CalPlug/ADE9078-3PhaseWattmeter/PCBDesign/1.4Fv3(PCB Populated)/Board PDF images/layout_images/IMG_20190212_175402.jpg

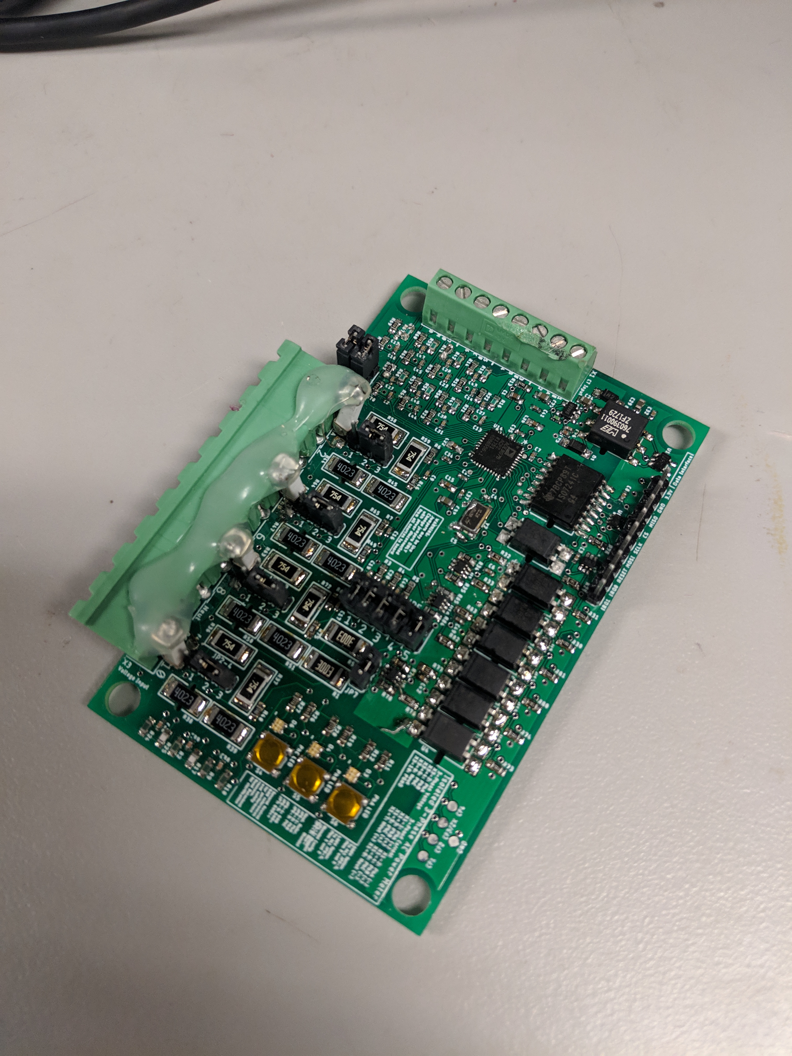
PCBDesign/1.4Fv3(PCB Populated)/Board PDF images/layout_images/IMG_20190212_175402.jpg
