CalPlug/ADE9078-3PhaseWattmeter/README.md

# ADE9078-3PhaseWattmeter
An Isolated design demo board using the ADE7953 3 phase AC wattmeter.  Design allows both WYE (STAR) and Delta (TRIANGLE) distributions to be measured along with Blondel and non-Blondel measurement schemes.  Project includes a demo ADE9078 Arduino firmware
