CalPlug/ADE9078-3PhaseWattmeter/PCBDesign/1.4Fv4/Readme.txt

This version contains minor updates post population.  These updates have been propataged the BOM and PCN layout
--M.J. Klopfer (/4/12/2019)
