CalPlug/ADE9078-3PhaseWattmeter/Firmware/FPGAPreliminaryFirmware/readme.txt

This is a skeleton layout of a Lattice iCE 40 interface over SPI to the ADE9078.  It is not complete at the current time, all basic features have not been implemented.
