CalPlug/ADE9078-3PhaseWattmeter/Firmware/ArduinoFirmware/ADE9078/examples/resampledWFB_readall/README.txt

reads all 512 samples at once instead of 64x8

in LastReads.h, change WFB_RESAMPLE_SEGMENTS to 512
