CalPlug/ADE9078-3PhaseWattmeter/Documents/3 Phase Utility Service and Metering Configurations.pdf

### 3 Phase Utility Service and Metering Configurations

A review by Michael Klopfer, PhD

University of California, Irvine

California Plug Load Research Center (CalPlug)

California Institute of Telecommunications and Information Technology (Calit2)

V1.1

Overview: Distribution of AC power from generation to consumption points often relies on conversion between polyphase (almost always 3-phase) and single phase AC. Three phase power in general allows more power to be delivered to loads with less wire cost as well as providing consistent instantaneous power across a single AC cycle. In this document we will briefly discuss service configurations and accepted metering strategies.

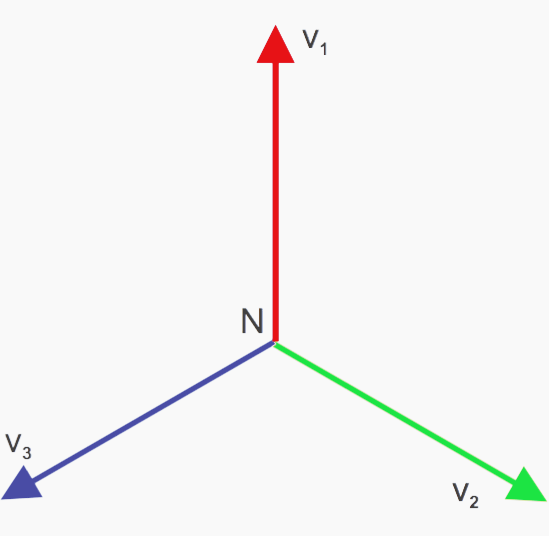
[picture p17: figure]
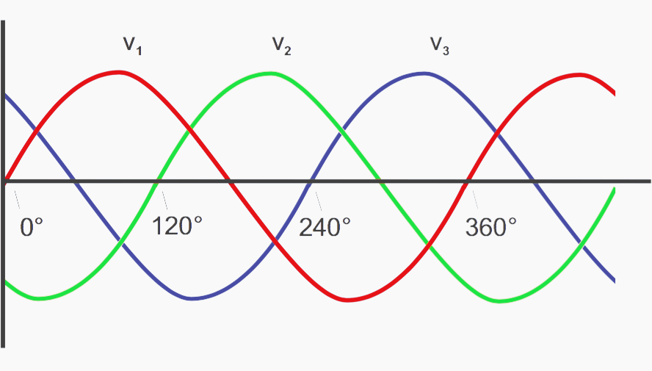
[picture p18: figure]

Figure 1: Three phase voltage represented in both waveform (left) and phase (right) diagrams.

Utility Internal Service: 3-phase transmission (shown in time and phase diagrams in Figure 1) and early distribution service is typically delta configured. Towards the final utility distribution transformer, the 3-phase service is typically provided in either Wye [a.k.a STAR] (3 or 4 lines, typically 4 lines including each phase and an active neutral that may be used for power return), or Delta [a.k.a TRIANGLE] (3 phases and often if a neutral is included, it is not used for primary power return), see Figure 2. For long stretches of transmission delta is preferred due to the lack of need for a power return neutral of sufficient carrying capacity.

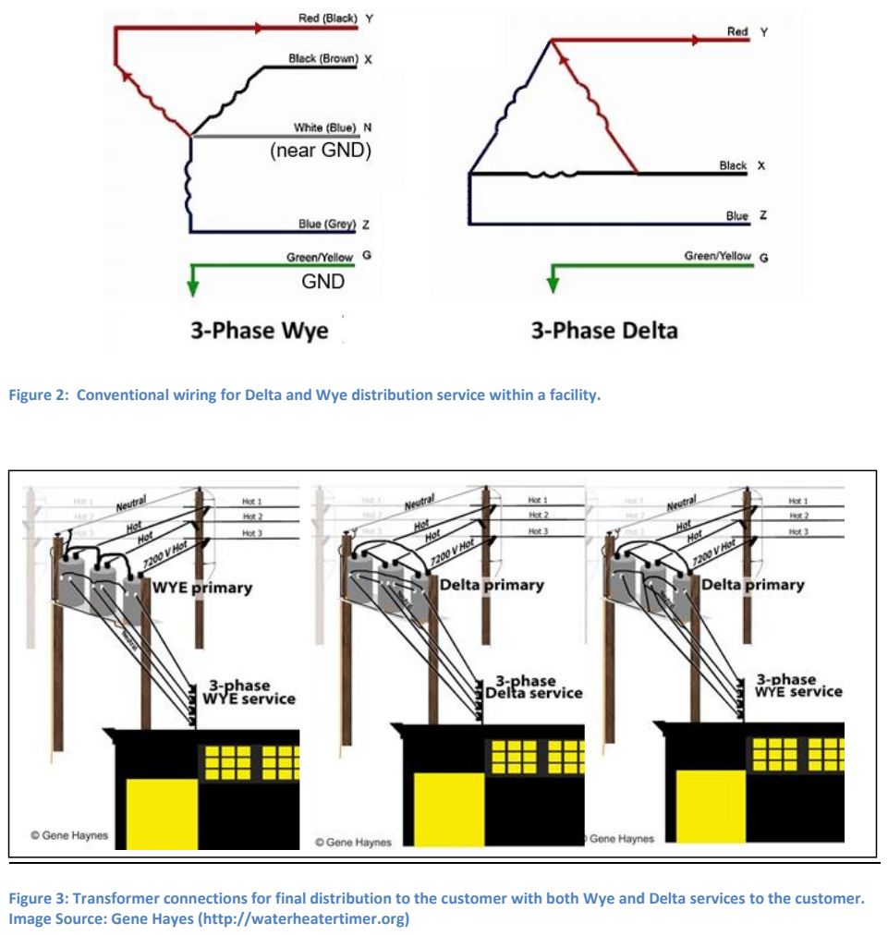
[picture p19: page 2]

Figure 2: Conventional wiring for Delta and Wye distribution service within a facility.

Figure 3: Transformer connections for final distribution to the customer with both Wye and Delta services to the customer. Image Source: Gene Hayes (http://waterheatertimer.org)

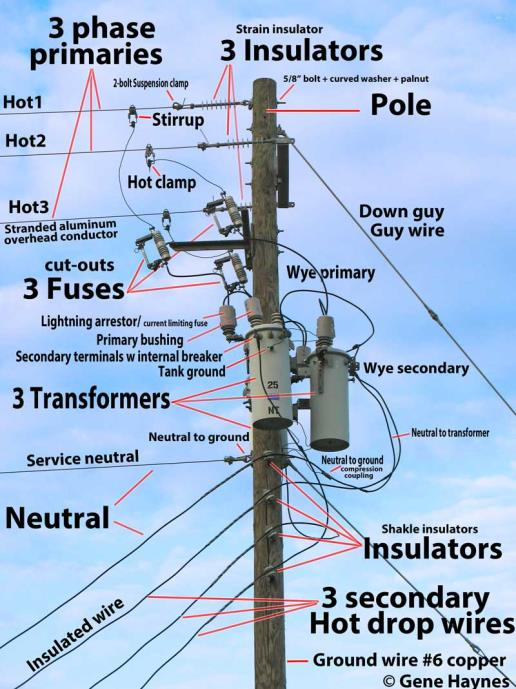
[picture p20: figure]
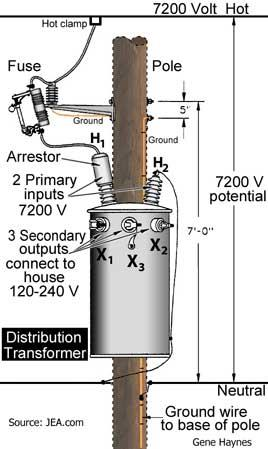
[picture p21: figure]

Figure 4(a,b): In end-pint distribution networks, a Wye- Wye configurations are common either multiple (a) primaries or a singular primary to neutral (b) can be provided to the transformer prior to the customer. Image Source: Gene Hayes (http://waterheatertimer.org)

Typically large-scale utility connections are delta configured. A neutral may be carried along that is grounded at multiple points but it is not used for active intended power carrying in delta configuration. Closer to distribution endpoints utility configuration typically remains as delta up to the final distribution transformer, but in some cases it may enter Wye configuration prior to distribution. In general, closed Delta configurations use less wire (typically expensive copper) in use and balance voltage that the expense of current. Delta systems are used for transmission even with current being potentially higher. A High leg delta is a configuration to provide a neutral and split phase in addition to 3 phase service with a limited load capacity. For Delta systems in general, the source of ground faults are difficult to detect due to lack of neutral comparison reference against each phase.

Utility to customer service: At the transition point where power is provided to the customer, the service is often provided as Delta (for major loads such as large motors or lighting services), Wye (general purpose loads, lighting, and loads requiring neutrals), or Split Phase (provided to residences). Service to most commercial buildings is 208V (phase to phase) 3-phase (Wye) or 480V (phase to phase) 3-phase (Wye), this configuration provides a neutral.

Table 1 shows common US and international service configurations. Figure 2 shows the typical layout for both conventional Delta and Wye configurations. Some atypical services include low service capacity high-leg deltas which provide a 120/240 split-phase in addition to a 3-phase delta service which may find service in applications such as small apartment buildings using 3-phase elevators or HVAC units along with conventional 120/240V service.

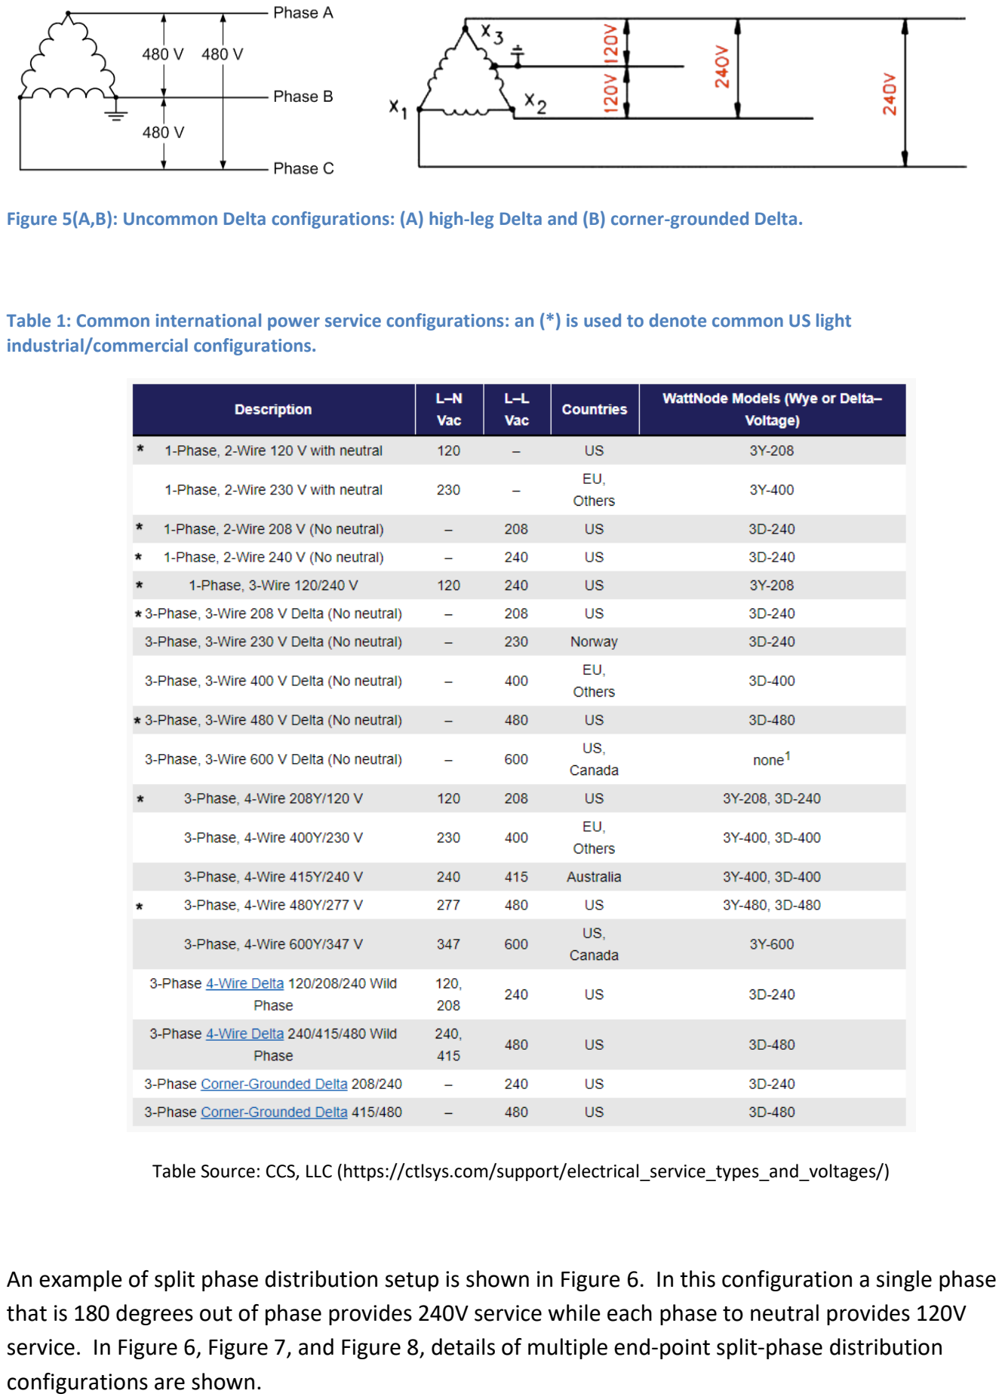
[picture p22: page 4]

Figure 5(A,B): Uncommon Delta configurations: (A) high-leg Delta and (B) corner-grounded Delta.

Table 1: Common international power service configurations: an (*) is used to denote common US light industrial/commercial configurations.

Table Source: CCS, LLC (https://ctlsys.com/support/electrical_service_types_and_voltages/)

An example of split phase distribution setup is shown in Figure 6. In this configuration a single phase that is 180 degrees out of phase provides 240V service while each phase to neutral provides 120V service. In Figure 6, Figure 7, and Figure 8, details of multiple end-point split-phase distribution configurations are shown.

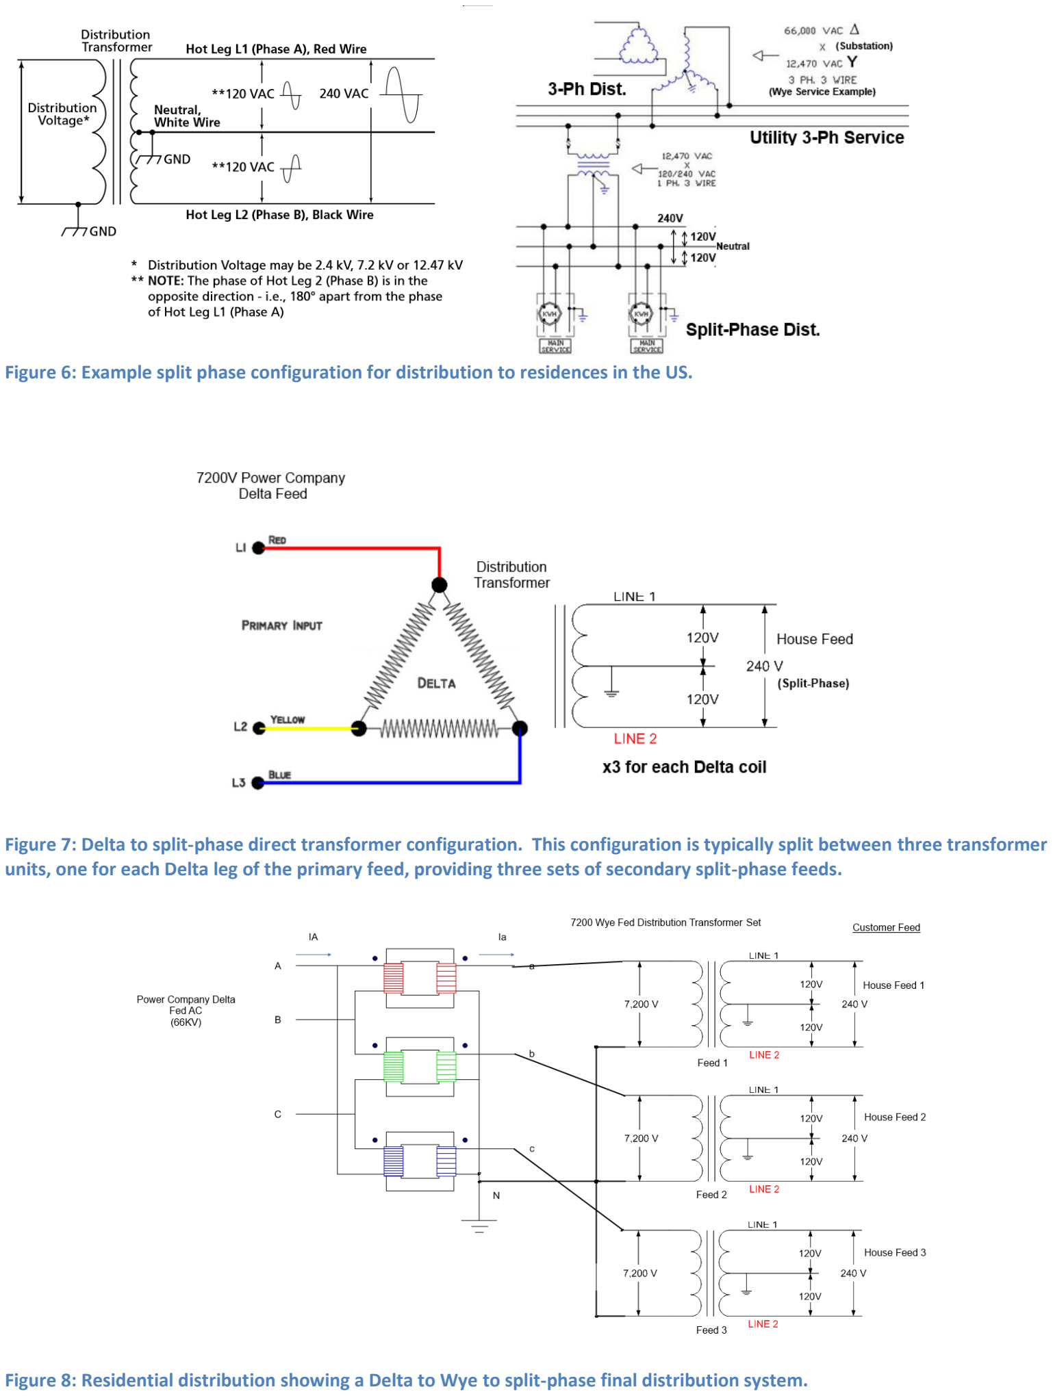
[picture p23: page 5]

Figure 6: Example split phase configuration for distribution to residences in the US.

Figure 7: Delta to split-phase direct transformer configuration. This configuration is typically split between three transformer units, one for each Delta leg of the primary feed, providing three sets of secondary split-phase feeds.

Figure 8: Residential distribution showing a Delta to Wye to split-phase final distribution system.

Measurement of Power in Split Phase and 3 Phase Service:

Blondel’s theorem indicates in multiple measurement cases (n-1) total phases are the required meters needed to know total energy consumption for a polyphase circuit in configurations that adhere to Blondel theorem. Under-defined configurations (non-Blondel compliant) can occur when neutrals are in use and in which case explicit metering on each pathway is required. Below are shown are several split-phase and 3 phase configurations that are commonly used along with metering strategies and identification of Blondel’s theorem compliance for each configuration.

Case 0: Split phase AC distribution using a “Form2S” type meter. Form 3S meters use external current transformers for measuring large loads. The sum of the power calculated on each of the split phases is total power consumption. This is a common configuration for utility meters for split-phase supplied homes. The neutral return for either of the split-phases makes this distribution configuration non-Blondel theorem compliant- each phase must be independently metered to measure total energy consumption.

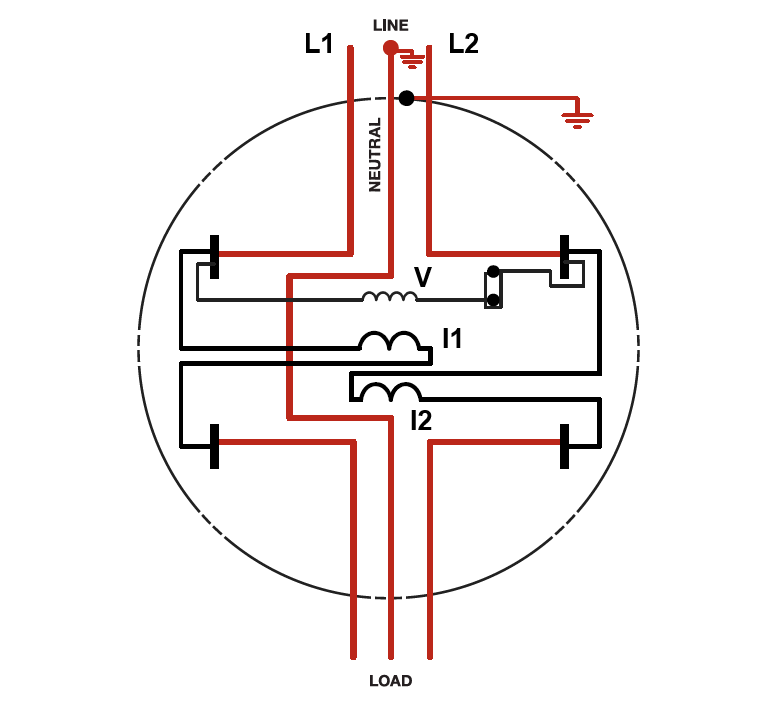
[picture p24: figure]

Case 1 and Case 2: Either (1) Wye (no neutral) or (2) delta 3-phase service (non-Blondel compliant) using 3 meters to measure 3 phases.

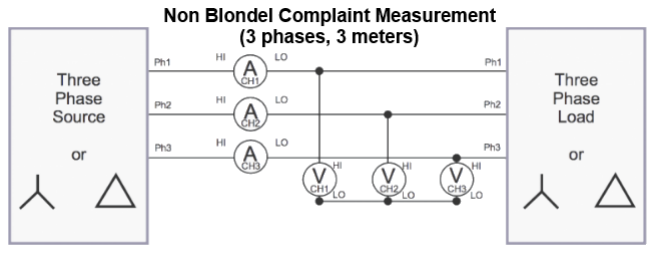
[picture p25: figure]

Case 3: Wye configuration with a neutral. This configuration is not Blondel compliant (or could ever be) because of the neutral. Each phase must be monitored and the power on the neutral is (typically) calculated by process of Kirchoff's laws. This configuration is typical for many commercial buildings because 208V phase-phase provides 120V phase to neutral for service outlets. Figure Source: https://electrical-engineering-portal.com/three-phase-power-measurement#three-wattmeter-method

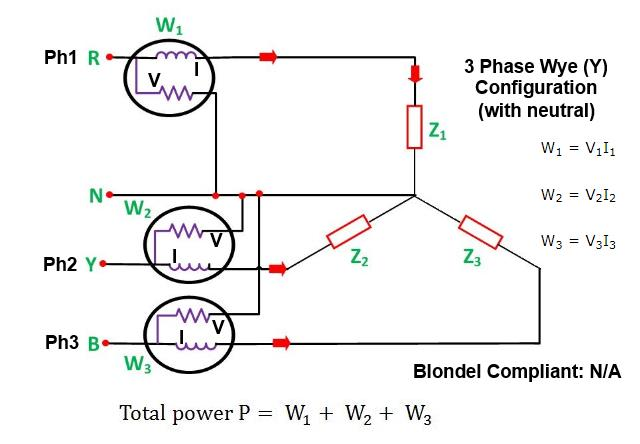
[picture p26: figure]

Case 4: Delta service: This Blondel compliant approach uses two meters to measure power across 3 phases.

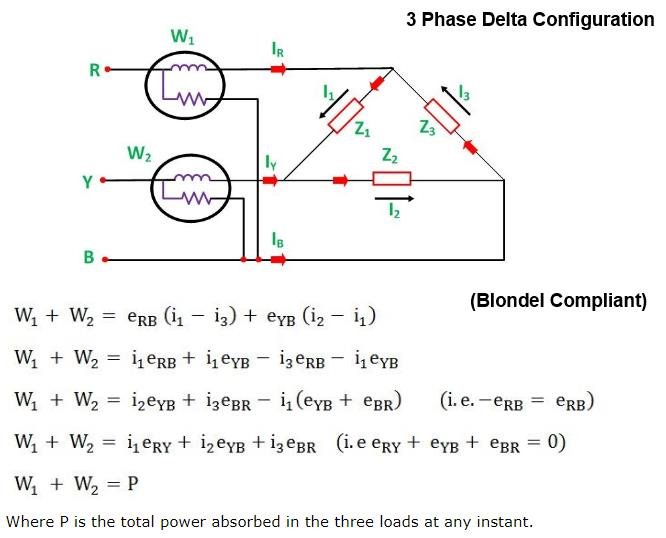
[picture p27: figure]

Case 5: Wye service without a neutral: This Blondel compliant approach uses two meters to measure power across 3 phases in a WYE service with no neutral in use.

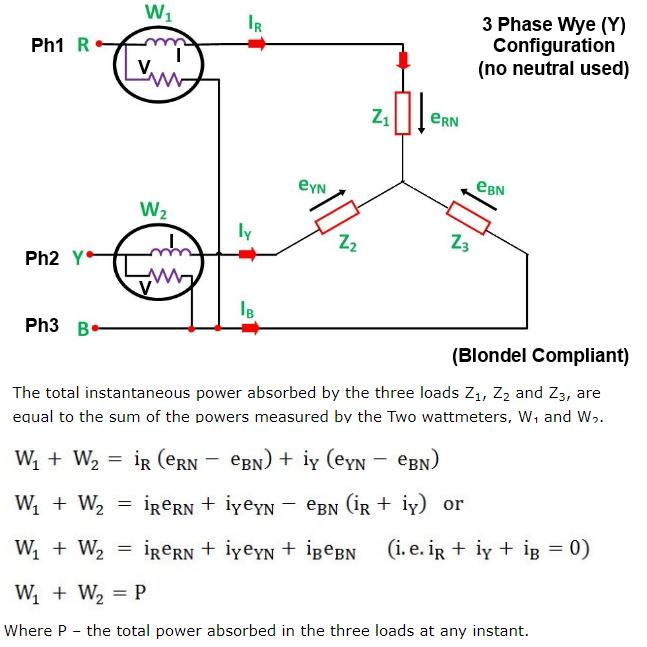
[picture p28: figure]
