CalPlug/ADE9078-3PhaseWattmeter/PCBDesign/simulations/LTSpice/Sim1-CTSimulationCurrentInput/image (50).png

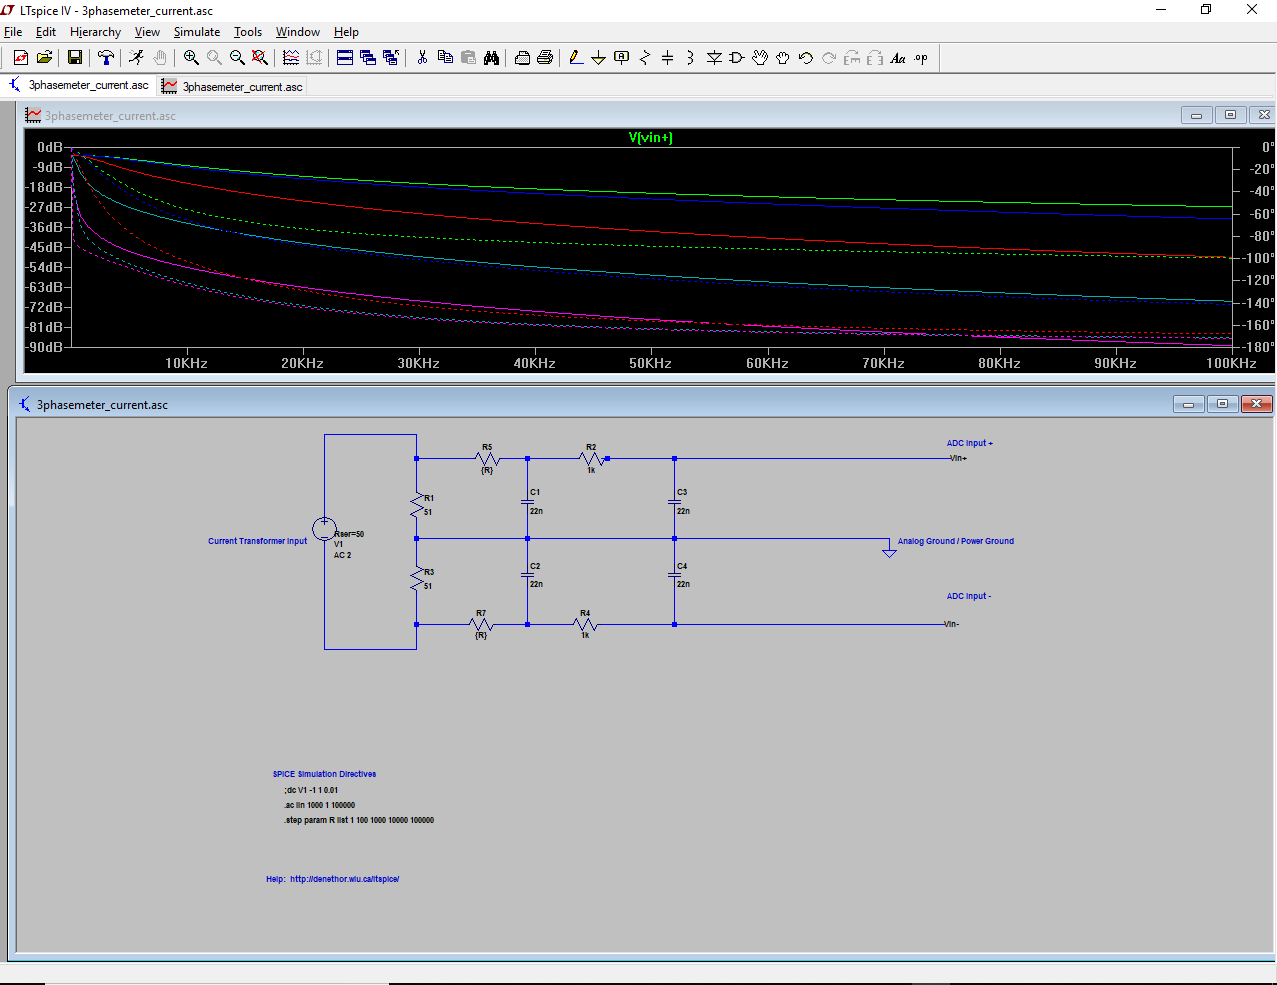
PCBDesign/simulations/LTSpice/Sim1-CTSimulationCurrentInput/image (50).png
