CalPlug/ADE9078-3PhaseWattmeter/PCBDesign/simulations/LTSpice/Sim1-CTSimulationCurrentInput/image (51).png

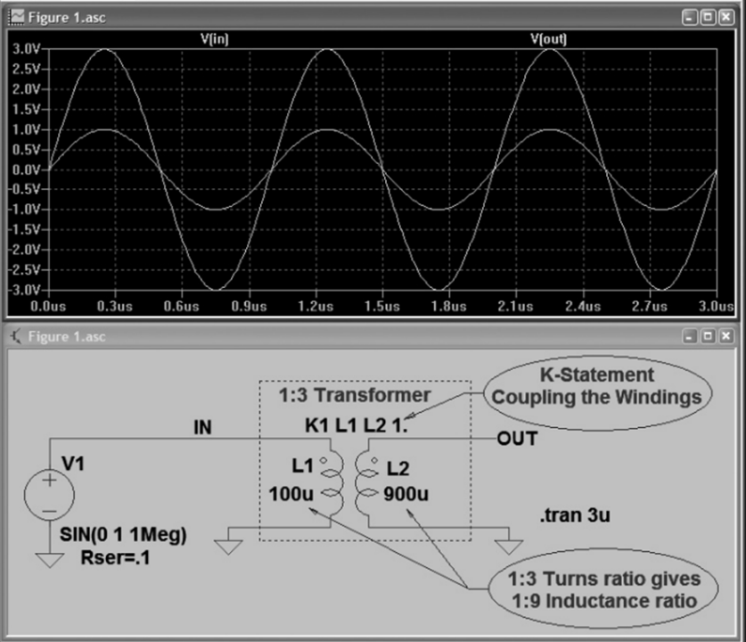
PCBDesign/simulations/LTSpice/Sim1-CTSimulationCurrentInput/image (51).png
