CalPlug/ADE9078-3PhaseWattmeter/PCBDesign/simulations/LTSpice/Sim1-CTSimulationCurrentInput/image (52).png

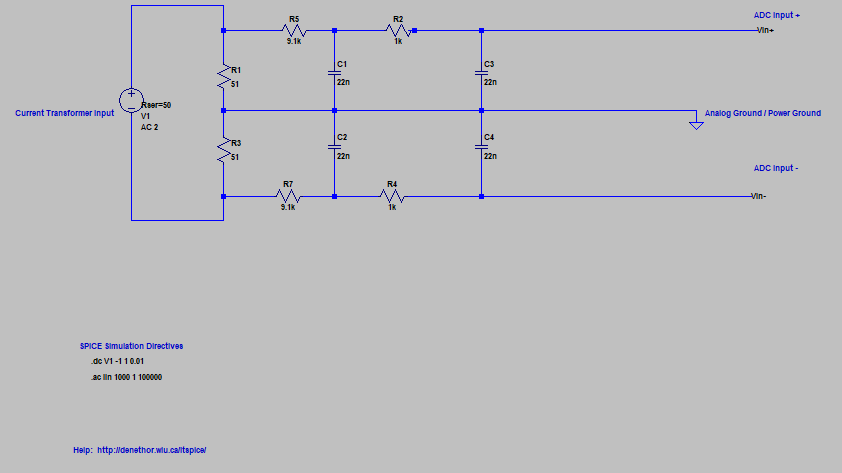
PCBDesign/simulations/LTSpice/Sim1-CTSimulationCurrentInput/image (52).png
