CalPlug/ADE9078-3PhaseWattmeter/PCBDesign/1.4Fv4/BOM - Three Phase Wattmeter.xlsx

Sheet: PCB SPECS (please fill in)
PCB
File Name | Material | Layer | Dimension(mm) |  | Quantity (5 min.) | Separated Different Design | Panelized PCBs | Solder Mask Color | Silkscreen Color | PCB Thickness | Copper Thickness | Inner Copper Thickness | Surface Finish
 |  |  | X | Y |  |  |  |  |  | (mm) | (oz) | (oz)
***.ZIP (your Gerber files) | FR-4 TG130 | 2 | 87.63 | 57.15 | 5 | 1 | Not Required | Green | White | 1.6 | 1 oz | 0.5 oz | HASL (Hot Air Surface Leveling)
SPECIAL REQUIREMENTS
Min. Tracking/Spacing | 6 mil
Min. Hole Size | 0.3 mm
BGA | No
Edge Connector | No
Blind Vias | No
Half Cutted Holes | No
Impedance Control | No
STENCIL
Stencil Dimensions | 190 x 290 mm (frameless)
Stencil Quantity | 1
Fiducial Mark | Yes
Polishing Technique | Polishing
REMARK
Milling slots on Layer 46, Holes on Layer 45

Sheet: BOM (please fill in)
BOM/PCBA quantity (Required) |  | 5.00
PCB/Project Name (Required) |  | 3 Phase Wattmeter
Part Identification |  |  |  |  |  | Customer Information |  | Quantity | Remark
# | Part ID / Reference (Required) | Value (Required) | Package (Required) | THT (y/n) | Pins / Pads Qty | Source/Link/ Datasheet/Note | Source / Target Price | Quantity per BOM (Required)
1 | C3,C6,C7,C8,C26,C32,C34,C37,C41,C42,C49 | CAP CER .1UF 16V | 0402 | n | 2 | https://www.mouser.com/ProductDetail/KEMET/C0402C104M4PACTU | $0.14 | 11
2 | C25 | CAP CER 1UF 16V | 0402 | n | 2 | https://www.mouser.com/ProductDetail/Murata-Electronics/GRM155C81C105ME11D | $0.27 | 1
3 | C2,C9,C10,C11,C12,C13,C14,C16,C17,C19,C20, | CAP CER 22NF 16V | 0402 | n | 2 | https://www.mouser.com/ProductDetail/Yageo/AC0402KRX7R7BB223 | $0.10 | 22
 | C21,C23,C28,C30,C31,C43,C44,C45,C46,C47,C48
4 | C15,C22,C36 | CAP CER 4.7 UF 16V | 0402 | n | 2 | https://www.mouser.com/ProductDetail/Murata-Electronics/GRM155R61A475MEAAD | $0.25 | 3
5 | C18,C35 | CAP CER .22uF 16V | 0402 | n | 2 | https://www.mouser.com/ProductDetail/Taiyo-Yuden/JMK105BJ224KE-R | $0.38 | 2
6 | C4,C5 | CAP CER 30pF 16V | 0402 | n | 2 | https://www.mouser.com/ProductDetail/Taiyo-Yuden/TMK042CG300JC-W | $0.10 | 2
7 | C38,C39,C40 | CAP CER 50nF 16V | 0402 | n | 2 | https://www.mouser.com/ProductDetail/TDK/C1005X8R1E473M050BC | $0.18 | 3
8 | C1 | CAP CER 1UF 16V | 0603 | n | 2 | https://www.mouser.com/ProductDetail/KEMET/C0603X105J4RACTU | $0.500 | 1
9 | C24,C27,C29,C33 | CAP CER 10UF 16V | 0603 | n | 2 | https://www.mouser.com/ProductDetail/KEMET/C0603C106M8PACTU | $0.500 | 4
10 | L1 | INDUCTOR 15nH | 0402 | n | 2 | https://www.mouser.com/ProductDetail/Murata-Electronics/LQG15WH15NJ02D | $0.17 | 1
11 | R16, R18, R42, R43, R54, R55, R66, R67 | 20 ohm res | 0603 | n | 2 | https://www.digikey.com/product-detail/en/te-connectivity-passive-product/CPF0603F4R99C1/A102290CT-ND/2728264 | $0.14 | 8
12 | R14, R22, R41, R56, R57, R60, R68, R69 | 100 ohm res | 0603 | n | 2 | https://www.digikey.com/product-detail/en/susumu/RR0816P-101-D/RR08P100DCT-ND/432700 | $0.11 | 8
13 | R29, R32, R33, R76, R77, R82, R83 | 560 ohm res,100V,100mW | 0603 | n | 2 | https://www.mouser.com/ProductDetail/Susumu/RGT1608P-561-B-T5 | $0.73 | 7
14 | R3, R4,R5,R6,R7,R8,R15,R21,R23, R53, R61, R62, R70, R71 | 1k Ohm res, 75V, 100mW | 0603 | n | 2 | https://www.mouser.com/ProductDetail/Yageo/AT0603BRD071KL | $0.60 | 14
15 | R13,R28,R30,R31, R73, R74, R80, R81 | 4.7k ohm res, 75V,100mW | 0603 | n | 2 | https://www.mouser.com/ProductDetail/Vishay/CRCW06034K70FKEAC | $0.17 | 8
16 | R2, R9, R10, R11, R12, R17, R19, R20, R24, R25, R26,R27 | 5k ohm,75V,62.5mW | 0603 | n | 2 | https://www.mouser.com/ProductDetail/KOA-Speer/RN731JTTD5051B25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 | $0.67 | 12
17 | R34,R35, R78, R79, R84, R85 | 10k ohm res,75V,100mW | 0603 | n | 2 | https://www.mouser.com/ProductDetail/Vishay/CRCW060310K0JNEAC | $0.17 | 6
18 | R1, R52 | 300k ohm,200V,750mW | 2010 | n | 2 | https://www.mouser.com/ProductDetail/Yageo/RC2010FK-07300KL | $0.30 | 2
19 | R38,R39,R44, R45, R47, R48, R50, R51 ** Values changes from last sch | 120k ohm,200V, 750mW | 2010 | n | 2 | https://www.mouser.com/ProductDetail/Yageo/RC2010JK-07120KL | $0.22 | 8
20 | R36,R37, R58, R59, R63, R64, R65, R72 ** | 245k ohm,200V,750mW | 2010 | n | 2 | https://www.mouser.com/ProductDetail/Panasonic/ERJ-12ZYJ244U | $0.30 | 8
21 | R40, R46, R49, R75 ** | 120k ohm,75V,100mW | 0603 | n | 2 | https://www.mouser.com/ProductDetail/Vishay/CRCW0603120KFKEAC | $0.17 | 4
22 | U14 | Energy Metering IC | ADE 9078 | n | 40 | https://www.mouser.com/ProductDetail/Analog-Devices/ADE9078ACPZ | $12.280 | 1
23 | S4, S5, S6 | Switch | TACTILE_SWITCH_SMD_4.5MM | n | 2 | https://www.digikey.com/product-detail/en/TL3315NF100Q/EG4620CT-ND/1870400/?itemSeq=283064735 | $0.230 | 3
24 | X3 | 10 Pins Terminal Block | MSTBA10 | n | 10 | https://www.mouser.com/ProductDetail/Phoenix-Contact/1757323 | $3.240 | 1
25 | X1 | 8 Pins Terminal Block | MKDS 1/ 8-3,5 |  | 8 | https://www.mouser.com/ProductDetail/Phoenix-Contact/1751303?qs=sGAEpiMZZMuVJC7Vq%252bMl5xHSGUvYpdrt | $5.010 | 1
26 | F1, F2, F3, F4 | Fuses | Surface Mount Fuses | n | 2 | https://www.mouser.com/ProductDetail/Littelfuse/0461500ER | $1.720 | 4
27 | D3, D4, D6 | LED | Bi-Color LEDs (Red/Green) | n | 4 | https://www.mouser.com/ProductDetail/Wurth-Electronics/150066SV74000 | $0.400 | 3
28 | D1, D2 | Diode | MBR0520LT | n | 2 | https://www.digikey.com/product-detail/en/micro-commercial-co/MBR0520-TP/MBR0520TPMSCT-ND/717365 | $0.420 | 2
29 | U2,U3,U4,U6,U9,U15,U17 | PS2505 (High isolation voltage connector) | PS2505 | n | 4 | https://www.digikey.com/product-detail/en/cel/PS2505L-1-F3-A/PS2505L-1-F3-ACT-ND/3646235 | $0.940 | 7
30 | U1,U5,U7,U16 | SN74LVC2G (Dual not gate) | SN74LVC2G | n | 6 | https://www.mouser.com/ProductDetail/Texas-Instruments/SN74LVC2G14DCKT?qs=pajgIaoyDUjydEkjtB9Zqw%3D%3D | $0.940 | 3
31 | U8 | NL17SZ125 (Tri state buffer) | NL17SZ125 | n | 5 | https://www.digikey.com/product-detail/en/on-semiconductor/NL17SZ125DFT2G/NL17SZ125DFT2GOSCT-ND/1139962 | $0.320 | 1
32 | U10 | ISO 7241 | ISO 7241 | n | 16 | https://www.digikey.com/product-detail/en/texas-instruments/ISO7241CDWR/296-37636-1-ND/4833880 | $4.970 | 1
33 | U12 | SN6501 (Transformer driver for isolated power) | SN6501 | n | 5 | https://www.digikey.com/product-detail/en/texas-instruments/SN6501DBVR/296-37700-1-ND/4833928 | $2.010 | 1
34 | U11 | PAM2305 | PAM2305 | n | 5 | https://www.digikey.com/product-detail/en/diodes-incorporated/PAM2301CAAB330/PAM2301CAAB330DICT-ND/5267109 | $0.630 | 1
35 | U13 | TRANSFO_3.3 | TRANSFO_3.3 | n | 6 | https://www.digikey.com/product-detail/en/wurth-electronics-midcom/760390011/732-4455-1-ND/3831291 | $1.940 | 1
36 | J3 | Power, SPI, and IRQ Interface connection | 9 pin jumper | y | 9 | https://www.digikey.com/products/en?mpart=PREC040SAAN-RC&v=35 | $0.510 | 1
37 | JP2-1, JP2-2, JP2-3, JP2-4 | Jumper | 3x1 pin Jumpers (1/10 in spacing) | y | 3 | https://www.digikey.com/products/en?mpart=PREC040SAAN-RC&v=35 | $0.510 | 4
38 | JP5-1,JP5-2,JP5-3, JP5-4 | Jumper | 5x2 pin Jumper (1/10 in spacing) | y | 3 | https://www.digikey.com/products/en?mpart=PREC040SAAN-RC&v=35 | $0.510 | 4
39 | JP4-1, JP4-2 | Jumper | 2x2 pin Jumper (1/10 in spacing) | y | 2 | https://www.digikey.com/products/en?mpart=PREC040SAAN-RC&v=35 | $0.510 | 2
40 | JP7 | Jumper | 1x2 pin Jumper (1/10 in spacing) | y | 2 | https://www.digikey.com/products/en?mpart=PREC040SAAN-RC&v=35 | $0.510 | 1
41 | Y2 |  | Crystal clock 12.288 Mhz | n | 4 | https://www.digikey.com/product-detail/en/ABM3B-12.288MHZ-B2-T/535-9117-1-ND/675634/?itemSeq=283063244 | $1.090 | 1
42 | X3 - Male connectors |  | TERM BLOCK PLUG 10POS STR 5.08MM | y | 10 | https://www.digikey.com/product-detail/en/phoenix-contact/1757093/277-1019-ND/260387 | $9.490 | 1
43
44
45
46
47
48
49
50
51
52

Sheet: Shipping Details (Example)
The shipping information could help us to estimate the shipping cost.
Consignee | Michael Klopfer (Technical) / Alise Adams`(Purchasing)
Company Name | California Plug Load Research Center
Address 1 | 4100 Calit2 Building
Address 2 | UC Irvine
City | Irvine, California
Postcode | 92697
State | California
Country | USA
Telephone Number | 310-502-1971 (Technical Concerns)
Email Address | mklopfer@uci.edu (Technical Concerns) alisea@uci.edu (Billing Concerns)
