CalPlug/ADE9078-3PhaseWattmeter/PCBDesign/1.4Fv3(PCB Populated)/BOM (NOA LABS TEMPLATE) March 2019.xlsx

Sheet: PCBA Components
BOM quantity (Required):
Project Name (Required): Polyphase Wattmeter
Total Cost:
Approval Date:
BOM Level | Quantity | Part Number | Part Name | Description | PCB Number | Manufacturer | Unit Cost (USD) | Ext. Cost (USD) | Notes
 |  | For One Board
 | 11 | C0402C104M4PACTU | 0402-CAP | CAP CER .1UF 16V | C3,C6,C7,C8,C26,C32,C34,C37,C41,C42,C49 | KEMET | $0.140 | $1.540 | https://www.mouser.com/ProductDetail/KEMET/C0402C104M4PACTU
 | 1 | GRM155C81C105ME11D | 0402-CAP | CAP CER 1UF 16V | C25 | Murata Electronics (https://www.mouser.com/murataelectronics/) | $0.270 | $0.270 | https://www.mouser.com/ProductDetail/Murata-Electronics/GRM155C81C105ME11D
 | 1 | C0603X105J4RACTU | 0603-CAP | CAP CER 1UF 16V | C1 | KEMET | $0.500 | $0.500 | https://www.mouser.com/ProductDetail/KEMET/C0603X105J4RACTU
 | 4 | C0603C106M8PACTU | 0603-CAP | CAP CER 10UF 16V | C24,C27,C29,C33 | KEMET | $0.510 | $2.040 | https://www.mouser.com/ProductDetail/KEMET/C0603C106M8PACTU
 | 22 | AC0402KRX7R7BB223 | 0402-CAP | CAP CER 22NF 16V | C2,C9,C10,C11,C12,C13,C14,C16,C17,C19,C20,C21,C23,C28,C30,C31,C43,C44,C45,C46,C47,C48 | Yageo (https://www.mouser.com/yageo/) | $0.100 | $2.200 | https://www.mouser.com/ProductDetail/Yageo/AC0402KRX7R7BB223
 | 3 | GRM155R61A475MEAAD | 0402-CAP | CAP CER 4.7 UF 16V | C15,C22,C36 | Murata Electronics (https://www.mouser.com/murataelectronics/) | $0.250 | $0.750 | https://www.mouser.com/ProductDetail/Murata-Electronics/GRM155R61A475MEAAD
 | 2 | JMK105BJ224KE-R | 0402-CAP | CAP CER .22uF 16V | C18,C35 | Taiyo Yuden (https://www.mouser.com/taiyo-yuden/) | $0.380 | $0.760 | https://www.mouser.com/ProductDetail/Taiyo-Yuden/JMK105BJ224KE-R
 | 2 | TMK042CG300JC-W | 0402-CAP | CAP CER 30pF 16V | C4,C5 | Taiyo Yuden | $0.100 | $0.200 | https://www.mouser.com/ProductDetail/Taiyo-Yuden/TMK042CG300JC-W
 | 3 | C1005X8R1E473M050BC | 0402-CAP | CAP CER 50nF 16V | C38,C39,C40 | TDK | $0.180 | $0.540 | https://www.mouser.com/ProductDetail/TDK/C1005X8R1E473M050BC
 | 1 | LQG15WH15NJ02D | 0402-INDO | INDUCTOR 15nH | L1 | Murata Electronics | $0.170 | $0.170 | https://www.mouser.com/ProductDetail/Murata-Electronics/LQG15WH15NJ02D
 | 8 | A102290CT-ND | 0603-RES | 5 ohm res | R16, R18, R42, R43, R54, R55, R66, R67 |  | $0.140 | $1.120 | https://www.digikey.com/product-detail/en/te-connectivity-passive-product/CPF0603F4R99C1/A102290CT-ND/2728264
 | 8 | CRCW06030000Z0EAC | 0603-RES | 0 ohm res | R14, R22, R41, R56, R57, R60, R68, R69 | Vishay | $0.100 | $0.800 | https://www.mouser.com/ProductDetail/Vishay/CRCW06030000Z0EAC
 | 7 | RGT1608P-561-B-T5 | 0603-RES | 560 ohm res, 100V, 100mW | R29, R32, R33, R76, R77, R82, R83 | Susumu | $0.730 | $5.110 | https://www.mouser.com/ProductDetail/Susumu/RGT1608P-561-B-T5
 | 20 | AT0603BRD071KL | 0603-RES | 1k Ohm res, 75V, 100mW | R3, R4,R5,R6,R7,R8,R11,R12,R15,R19,R20,R21,R23,R26,R27, R53, R61, R62, R70, R71 | Yageo | $0.600 | $12.000 | https://www.mouser.com/ProductDetail/Yageo/AT0603BRD071KL
 | 8 | CRCW06034K70FKEAC | 0603-RES | 4.7k ohm res, 75V, 100mW | R13,R28,R30,R31, R73, R74, R80, R81 | Vishay | $0.170 | $1.360 | https://www.mouser.com/ProductDetail/Vishay/CRCW06034K70FKEAC
 | 8 | RN731JTTD5051B25 | 0603-RES | 5.05k ohm res, 75V, 62.5mW | R2, R9, R10, R17, R24, R25 | KOA Speer | $0.670 | $5.360 | https://www.mouser.com/ProductDetail/KOA-Speer/RN731JTTD5051B25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
 | 6 | CRCW060310K0JNEAC | 0603-RES | 10k ohm res, 75V, 100mW | R34,R35, R78, R79, R84, R85 | Vishay | $0.170 | $1.020 | https://www.mouser.com/ProductDetail/Vishay/CRCW060310K0JNEAC
 | 2 | RC2010FK-07300KL | 2010-RES | 300k ohm res, 200V, 750mW | R1, R52 | Yageo | $0.300 | $0.600 | https://www.mouser.com/ProductDetail/Yageo/RC2010FK-07300KL
 | 12 | RC2010JK-07120KL | 2010-RES | 120k ohm res | R38,R39, R44, R45, R47, R48, R50, R51 | Vishay | $0.220 | $2.640 | https://www.mouser.com/ProductDetail/Yageo/RC2010JK-07120KL
 | 3 | CRCW0603120KFKEAC | 0603-RES | 120k ohm res | R40, R46, R49, R75 | Vishay | $0.066 | $0.198 | https://www.mouser.com/ProductDetail/Vishay/CRCW0603120KFKEAC
 | 8 | CRCW2010243KFKEF | 2010-RES | 245k ohm res | R36,R37, R58, R59, R63, R64, R65, R72 | Vishay | $0.320 | $2.560 | https://www.mouser.com/ProductDetail/Vishay/CRCW2010243KFKEF?qs=sGAEpiMZZMvdGkrng054t3RItZpbp26uupapXTIpulc%3D
 | 1 | ADE9078ACPZ | ADE9078 | Energy Metering IC | U14 | Analog Devices | $12.280 | $12.280 | https://www.mouser.com/ProductDetail/Analog-Devices/ADE9078ACPZ
 | 3 | TL3305BF260QG | TACTILE_SWITCH_SMD_4.5MM | Switch | S4, S5, S6 | E-Switch | $0.230 | $0.690 | https://www.digikey.com/product-detail/en/TL3315NF100Q/EG4620CT-ND/1870400/?itemSeq=283064735
 | 1 | 1757323 | MSTBA10 | 10 Pins Terminal Block | X3 | Phoenix Contact | $3.240 | $3.240 | https://www.mouser.com/ProductDetail/Phoenix-Contact/1757323
 | 1 | 1751303 | MKDS 1/ 8-3,5 | 8 Pins Terminal Block | X1 | Phoenix Contact | $5.010 | $5.010 | https://www.mouser.com/ProductDetail/Phoenix-Contact/1751303?qs=sGAEpiMZZMuVJC7Vq%252bMl5xHSGUvYpdrt
 | 3 | 0461.500ER | Surface Mount Fuses | Fuses | F1, F2, F3 | Littelfuse | $1.720 | $5.160 | https://www.mouser.com/ProductDetail/Littelfuse/0461500ER
 | 3 | 150066SV74000 | Bi-Color LEDs (Red/Green) | LED | D3, D4, D6 | Wurth Electronics | $0.400 | $1.200 | https://www.mouser.com/ProductDetail/Wurth-Electronics/150066SV74000
 | 2 | MBR0520-TP | MBR0520LT | Diode | D1, D2 | Micro Commercial Co (https://www.digikey.com/en/supplier-centers/m/micro-commercial-components) | $0.420 | $0.840 | https://www.digikey.com/product-detail/en/micro-commercial-co/MBR0520-TP/MBR0520TPMSCT-ND/717365
 | 7 | PS2505L-1-F3-A | PS2505 | PS2505 (High isolation voltage connector) | U2,U3,U4,U6,U9,U15,U17 | CEL | $0.940 | $6.580 | https://www.digikey.com/product-detail/en/cel/PS2505L-1-F3-A/PS2505L-1-F3-ACT-ND/3646235
 | 3 | SN74LVC2G14DCKT | SN74LVC2G | SN74LVC2G (Dual not gate) | U1,U5,U7,U16 | Texas Instruments | $0.940 | $2.820 | https://www.mouser.com/ProductDetail/Texas-Instruments/SN74LVC2G14DCKT?qs=pajgIaoyDUjydEkjtB9Zqw%3D%3D
 | 1 | NL17SZ125DFT2G | NL17SZ125 | NL17SZ125 (Tri state buffer) | U8 | ON Semiconductor | $0.320 | $0.320 | https://www.digikey.com/product-detail/en/on-semiconductor/NL17SZ125DFT2G/NL17SZ125DFT2GOSCT-ND/1139962
 | 1 | ISO7241CDWR | ISO 7241 | ISO 7241 | U10 | Texas Instruments | $4.970 | $4.970 | https://www.digikey.com/product-detail/en/texas-instruments/ISO7241CDWR/296-37636-1-ND/4833880
 | 1 | SN6501DBVR | SN6501 | SN6501 (Transformer driver for isolated power) | U12 | Texas Instruments | $2.010 | $2.010 | https://www.digikey.com/product-detail/en/texas-instruments/SN6501DBVR/296-37700-1-ND/4833928
 | 1 | PAM2301CAAB330 | PAM2305 | PAM2305 | U11 | Diodes Incorporated | $0.630 | $0.630 | https://www.digikey.com/product-detail/en/diodes-incorporated/PAM2301CAAB330/PAM2301CAAB330DICT-ND/5267109
 | 1 | 760390011 | TRANSFO_3.3 | TRANSFO_3.3 | U13 | Wurth Electronics Midcom (https://www.digikey.com/en/supplier-centers/w/wurth-electronics-midcom) | $1.940 | $1.940 | https://www.digikey.com/product-detail/en/wurth-electronics-midcom/760390011/732-4455-1-ND/3831291
 | 1 | PREC040SAAN-RC | 9 pin jumper | Power, SPI, and IRQ Interface connection | J3 | Sullins Connector Solutions | $0.510 | $0.510 | https://www.digikey.com/products/en?mpart=PREC040SAAN-RC&v=35
 | 4 |  | 3x1 pin Jumpers (1/10 in spacing) | Jumper | JP2-1, JP2-2, JP2-3, JP2-4 | Sullins Connector Solutions | $0.510 | $2.040 | https://www.digikey.com/products/en?mpart=PREC040SAAN-RC&v=35
 | 4 |  | 5x2 pin Jumper (1/10 in spacing) | Jumper | JP5-1,JP5-2,JP5-3, JP5-4 | Sullins Connector Solutions | $0.510 | $2.040 | https://www.digikey.com/products/en?mpart=PREC040SAAN-RC&v=35
 | 2 |  | 2x2 pin Jumper (1/10 in spacing) | Jumper | JP4-1, JP4-2 | Sullins Connector Solutions | $0.510 | $1.020 | https://www.digikey.com/products/en?mpart=PREC040SAAN-RC&v=35
 | 1 |  | 1x2 pin Jumper (1/10 in spacing) | Jumper | JP7 | Sullins Connector Solutions | $0.510 | $0.510 | https://www.digikey.com/products/en?mpart=PREC040SAAN-RC&v=35
 | 1 | ABM3B-12.288MHZ-B2-T | Crystal clock 12.288 Mhz |  | Y2 | Abracon LLC (https://www.digikey.com/en/supplier-centers/a/abracon) | $1.090 | $1.090 | https://www.digikey.com/product-detail/en/ABM3B-12.288MHZ-B2-T/535-9117-1-ND/675634/?itemSeq=283063244
 | 1 | 277-1019-ND | TERM BLOCK PLUG 10POS STR 5.08MM |  | X3 - Male connectors | Phoenix Contact |  |  | https://www.digikey.com/product-detail/en/phoenix-contact/1757093/277-1019-ND/260387

Sheet: Purchased Parts
BOM quantity (Required):
Project Name (Required):
Total Cost:
Approval Date:
BOM Level | Quantity | Part Number | Part Name | Description | Manufacturer | MPN | Notes
ex | 1 | PUR20013-EXAMPLE | USB Cable | Male A/B 1 meter orange insulated jacket
MOUSER |  | MFG P/N
 | 40 | CRCW06034K70FKEAC | 0603 RESISTOR | 4.7k OHM 0603 SMD RESISTOR | VISHAY
 | 35 | RGT1608P-561-B-T5 | 0603 RESISTOR | 560 OHM | SUSUMU
 | 15 | GRM155R61A475MEAAD | 0402 CAP | 4.7 uF | MURATA
 | 15 | C1005X8R1E473M050BC | 0402 CAP | 47 nF | TDK
 | 5 | C0603X105J4RACTU | 0603 CAP | 1 uF | KEMET
 | 110 | AC0402KRX7R7BB223 | 0402 CAP | 22k pF = 22 nF | YAGEO
 | 140 | AT0603BRD071KL | 0603 RES | 1.0k OHM | YAGEO
 | 5 | LQG15WH15NJ02D | 0402 INDUCT | 15 nH | MURATA
 | 20 | C0603C106M8PACTU | 0603 CAP | 10 uF | KEMET
 | 55 | C0402C104M4PACTU | 0402 CAP | 0.1 uF | KEMET
 | 30 | PLT0603Z5000AST5 | 0603 RES | 500 OHM | VISHAY
 | 10 | JMK105BJ224KE-R | 0402 CAP | 0.22 uF | YUDEN
 | 5 | GRM155C81C105ME11D | 0402 CAP | 1 uF | MURATA
 | 10 | C0402C180F5GACTU | 0402 CAP | 18 pF | KEMET
 | 15 | 0461.500ER | Fuse |  | Littlefuse
 | 5 | 1757323 | 10 pin header |  | Phoenix Contact
 | 5 | 1751303 | 8 pin header |  | Phoenix Contact
 | 40 | ERJ-122ZYJ754U | 2010 RES | 750k | Panasonic
 | 15 | RT0603BRD07402KL | 0603 RES | 402k | YAGEO
 | 15 | 150066SV74000 | Bi-color LED |  | Wurth
 | 60 | CRCW2010402KFKEF | 2010 RES | 402k | Vishay
 | 40 | RN731JTTD5051B25 | 0603 RES | 5.05k | KOA Speer
 | 10 | RC2010FK-07300KL | 2010 RES | 300k | YAGEO
 | 30 | CRCW060310K0JNEAC | 0603 RES | 10k | Vishay
 | 15 | TL3305BF260QG | Switch |  | E-Switch
 | 5 | ADE9078ACPZ | ADE9078 |  | Analog Devices
Digikey
 | 5 | NL17SZ125DFT2G | U8 | TRI-STATE BUFFER | ON SEMI
 | 4 | S1012EC-40 | JP | JUMPERS | SULLINS
 | 1 | 760390011 | U13 | TRANSFORMER 1MH SMD | WURTH
 | 10 | MBR0520TPMSCT | D1, D2 | SCHOTTKY DIODE | MICRO
 | 5 | PAM2301CAAB330 | U11 | IC REG BCK 3.3V 0.8 | DIODES
 | 35 | PS2505L-1-F3-A |  | OPTOISOLATOR | CEL CALIF
 | 5 | ISO7241CDWR |  | DIGITAL ISO 2.5KV | TEXAS
 | 15 | SN74LVC1G3157DBVR |  | IC SWITCH SPDT | TEXAS
 | 5 | SN6501DBVR |  | IC REG CONV PWR SUPPLIES | TEXAS
AccuEnergy
 | 3 | AcuCT-H0603-50:333 |  |  | Accuenergy

Sheet: Fabricated Parts
BOM quantity (Required):
Project Name (Required):
Total Cost:
Approval Date:
BOM Level | Quantity | Part Number | Part Name | Description | Process Type | Material Type | Material Finish | Material Additives | Other Details | Bounding Width (mm) | Bounding Length (mm) | Bounding Height (mm) | Volume (cm^3) | Lead Time (wk) | MOQ | Fixed Cost (USD) | Unit Cost (USD) | Ext. Cost (USD) | Notes
 | 1 | FAB20015-EXAMPLE | Housing_Gasket | Housing Gasket | Compression Molding | TPE | N/A | N/A |  | 263.00 | 123.00 | 2.20 | 3673.00 |  |  | $1000.000 | $0.150 | $0.150
 | 1 | FAB20016-EXAMPLE | Housing_Top | Housing Top | Injection Molding | ABS | SPI-B2 | 30% GF |  | 274.00 | 125.00 | 25.00 | 14624.00 |  |  | $1000.000 | $0.260
 | 1 | FAB20017-EXAMPLE | Housing_Bottom | Housing Bottom | Injection Molding | ABS | SPI-B2 | 30% GF |  | 274.00 | 125.00 | 18.00 | 15234.00 |  |  | $1000.000 | $0.300
 | 1 | FAB20018-EXAMPLE | Home_Button | Home Button | Injection Molding | ABS | SPI-A2 | N/A |  | 35.00 | 35.00 | 13.00 | 542.00 |  |  | $1000.000 | $0.120

Sheet: Bare PCBs
BOM quantity (Required):
Project Name (Required):
Total Cost:
Approval Date:
BOM Level | Quantity | Part Number | Part Name | Description | Material Type | Layer Count | Length (mm) | Width (mm) | Thickness (mm) | Min Trace Width | Min Trace Spacing | Min Device Pitch | Via Types | Mounting Types | Lead Time (wk) | MOQ | Fixed Cost (USD) | Unit Cost (USD) | Ext. Cost (USD) | Notes
 | 1 | PCB20019-EXAMPLE | Main_PCB | Main PCB | FR-4 | 4 | 240.00 | 115.00 | 1.60 | 0.23 | 0.20 | 0.50 | Through | Through-Hole |  |  | $2000.000 | $1.230 | $1.230

Sheet: Packaging
BOM quantity (Required):
Project Name (Required):
Total Cost:
Approval Date:
BOM Level | Quantity | Part Number | Part Name | Description | Procurement Method | Lead Time (wk) | MOQ | Fixed Cost (USD) | Unit Cost (USD) | Ext. Cost (USD) | Notes
 | 1 | PACK001-EXAMPLE | Product Box | Printed Cardboard Product Box |  |  |  | $1000.000 | $2.250 | $2.250
