CalPlug/ADE9078-3PhaseWattmeter/Firmware/LinearCalibrationCalculator.xls

General Linear Calibration Calculator
Note: Adjust scope for charts and solver if points are added or removed (12 points shown)
Input 1 | Input 2 | Output | Output | Output | Output | Output | Output | Output | Output |  |  |  |  |  |  |  | Resulting Linear Regression
Pre-Calibration ADC Value | Reference Value (Known Value) | Initial Absolute Error | Initial Percent Error | Calculated Linear Regression Reference Vals | Reference to Calculated Absolute Error | Reference to Calculated Percent Error | Calculated Linear Regression ADC Vals | Reference to Calculated Absolute Error | Reference to Calculated Percent Error | Forward Data Trendline Vals | Slope: | 7.443333333 | Intercept: | 13.49333333 | R-Square Value | 0.9610826491 | EQN: | y= | 7.443333333 | x + | 13.49333333
0 | 19.6 | 19.60 | 0.00% | 13.49333333 | 6.11 | 45.26% | 0.9441617517 | 0.94 | 100.00%
1 | 21.4 | 20.40 | 4.90% | 20.93666667 | 0.46 | 2.21% | 1.176577618 | 0.18 | 15.01%
2 | 27.5 | 25.50 | 7.84% | 28.38 | 0.88 | 3.10% | 1.964209167 | 0.04 | 1.82% |  |  |  |  |  |  |  | Resulting Linear Regression
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
