CalPlug/ADE9078-3PhaseWattmeter/(threads)

Thread 1 (2019-03-26):

Calibration example

Mattsw23, 2019-03-26:
Hello,

I'm making a simple ade9078 board with esp32 I would like to use to read voltages and amps over time. I don't know if I'm wrong but this example rise lot of error on compiling.
first compiler run:
1)  'EEPROM' was not declared in this scope at line 203 so added EEPROM.h include and bypassed this.
2)  no matching function for call to 'ADE9078::ADE9078()' at line 291. I commented it and new error
3)'class ADE9078' has no member named 'writeWordToEeprom'.  ( this refer to ade9000 API??)

I'm little confused....    ade9000 which I previously used has i2c EEPROM and the ade9000 example use i2c to write to internal chip EEPROM.  I understand in your code you write directly to esp32 EEPROM to save data but looking at error 3 seems that you're referring to ade9000 api.
Can I ask you help about ? just to specify I defined the ESP32 architecture in .h

thanks Matt

mjklopfer, 2019-04-05:
right, this is getting fixed....

mjklopfer, 2019-06-11:
This chipset does not use UART/I2C, it is SPI only.  CRC function implemented and other garbage cleaned out, WFB is known working, direct calibration example (basic functionality that will need to be application adjusted) will be present in: https://github.com/CalPlug/ArduinoMenuCalibrator

Closed 2019-06-11.

Thread 4 (2024-04-01):

LastReads.h header file missing?

jhohsuwon, 2024-04-01:
LastReads.h does not exist in the Firmware/ArduinoFirmware/ADE9078 folder.

Could you help me?

DavidJayBrady, 2024-04-02:
https://github.com/CalPlug/ADE9078-3PhaseWattmeter/issues/2

Hopefully my coment from 2 years ago helps. It's been 5 years now so I don't remember much anymore
