CalPlug/ADE9078-3PhaseWattmeter/PCBDesign/1.4Fv4/1.4Fv4schematic.pdf

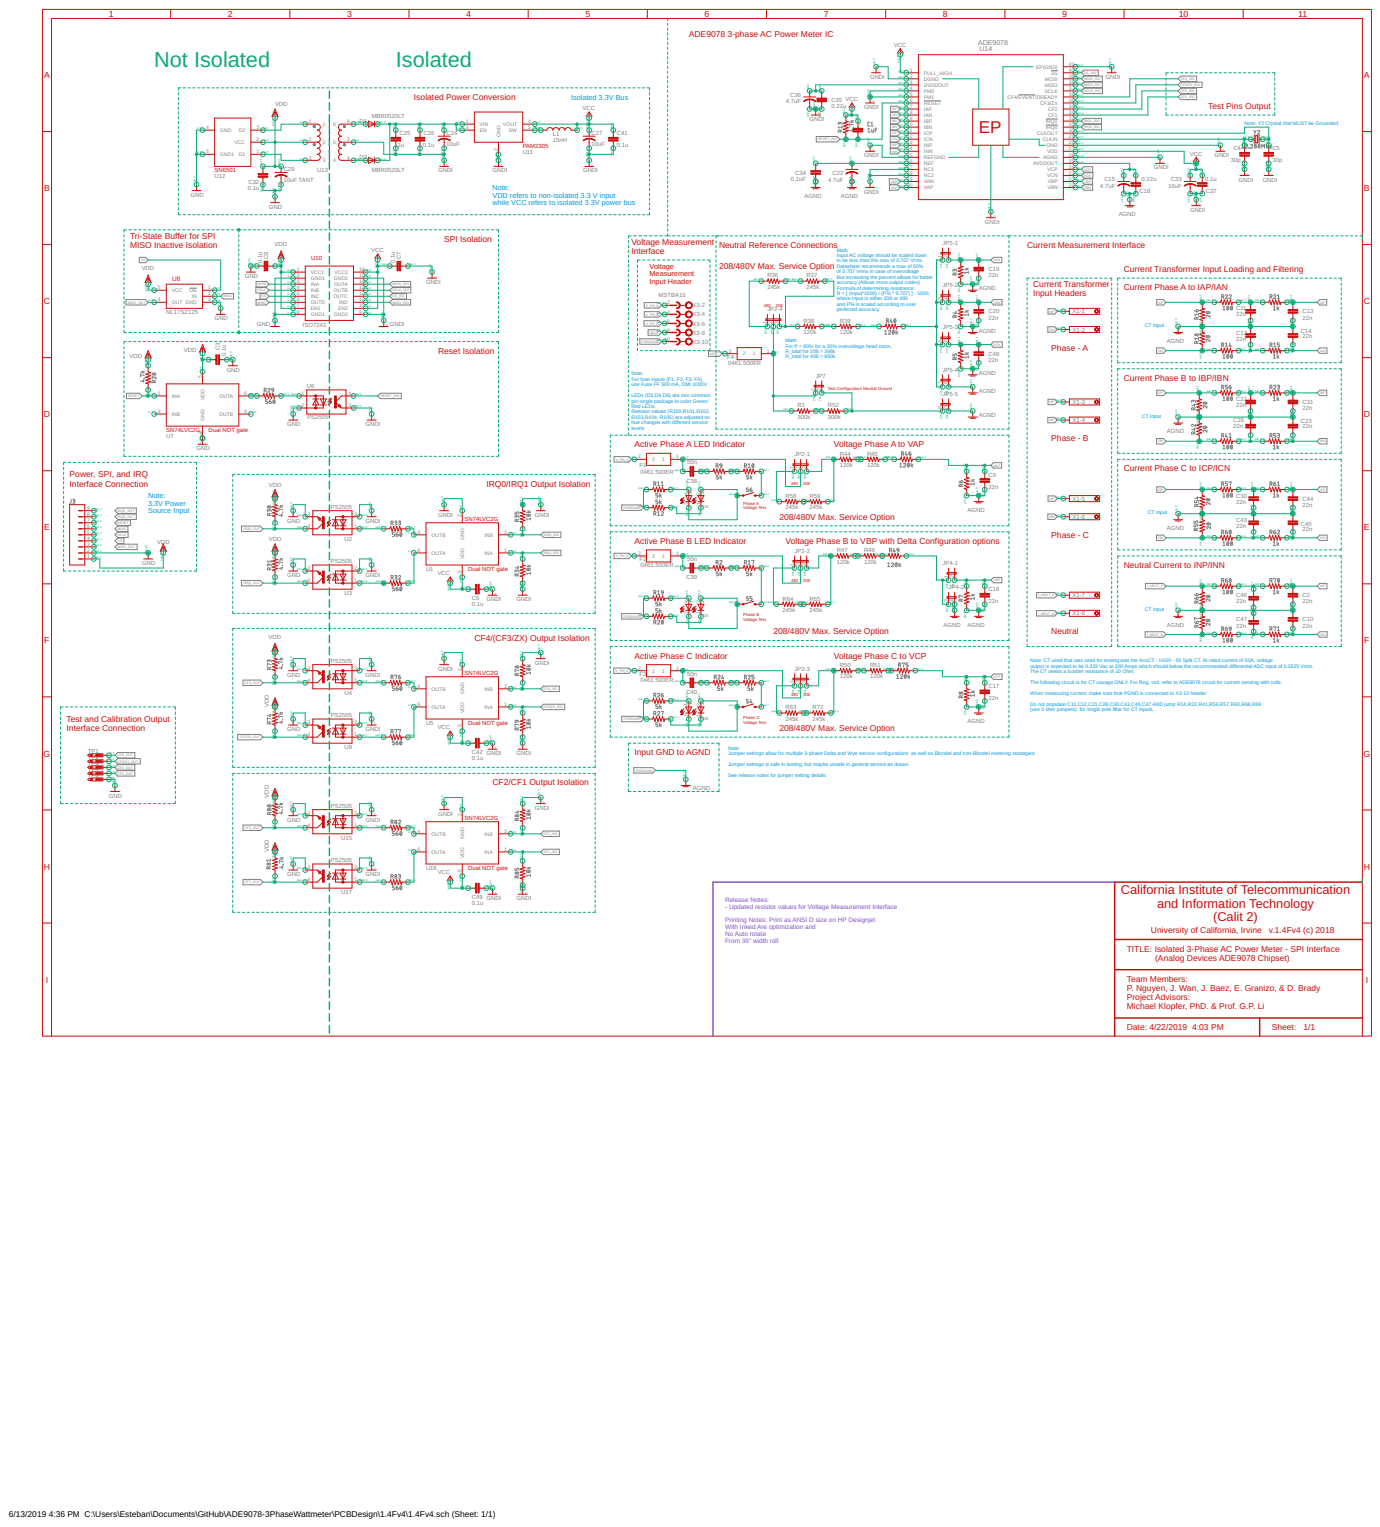
[picture p33: page 1]

ADE9078 3-phase AC Power Meter IC

Note: Y2 Crystal Xtal MUST be Grounded

Note:
VDD refers to non-isolated 3.3 V input
while VCC refers to isolated 3.3V power bus

SPI Isolation Tri-State Buffer for SPI
MISO Inactive Isolation

Math:
Input AC voltage should be scaled down
to be less than the max of 0.707 Vrms Datasheet recommends a max of 50%

pas 1 pas 1 pas 1

of 0.707 Vrms in case of overvoltage But increasing the percent allows for better accuracy (Allows more output codes) Formula of determining resistance: R = [ (Input*1000) / (P% * 0.707) ] - 1000, where Input is either 208 or 480

Current Transformer Input Loading and Filtering

sup 0 sup 0 sup 0 sup 0 sup 0
AGND

Current Phase A to IAP/IAN

pas 1 pas 1

pas 1 pas 1 pas 1 pas 1

and P% is scaled according to user perferred accuracy. Math: For P = 80% for a 20% overvoltage head room, R_total for 208 = 366k R_total for 408 = 850k

io 0 io 0 sup 0 as 1 pas 1

Note: For fuse inputs (F1, F2, F3, F4), use Fuse FF 500 mA, DMI 1000V

Current Phase B to IBP/IBN

Test Configuration Neutral Ground

LEDs (D3,D4,D6) are non common
pin single package bi-color Green/ Red LEDs. Resistor values (R100,R101,R102, R103,R104, R105) are adjusted so

hue changes with different service
levels

Active Phase A LED Indicator

Voltage Phase A to VAP

Current Phase C to ICP/ICN

Power, SPI, and IRQ

Active Phase B LED Indicator

Voltage Phase B to VBP with Delta Configuration options

Neutral Current to INP/INN

Dual NOT gate CF4/(CF3/ZX) Output Isolation

GNDI

Voltage Phase C to VCP

Note: CT used that was used for testing was the AcuCT - H100 - 50 Split CT. At rated current of 50A, voltage
output is expected to be 0.333 Vac at 200 Amps which should below the reccommended differential ADC input of 0.3535 Vrms. The CT needs a burden resistance of 10 Ohm. The following circuit is for CT usuage ONLY. For Rog. coil, refer to ADE9078 circuit for current sensing with coils. When measuring current, make sure that PGND is connected to X3-10 header Do not populate C11,C12,C21,C28,C30,C43,C46,C47 AND jump R14,R22,R41,R56,R57,R60,R68,R69

(use 0 ohm jumpers) for single pole filter for CT inputs.

Dual NOT gate Test and Calibration Output
Interface Connection

Note: Jumper settings allow for multiple 3-phase Delta and Wye service configurations as well as Blondel and non-Blondel metering strategies. Jumper settings is safe in testing, but maybe unsafe in general service as drawn. See release notes for jumper setting details.

Input GND to AGND

California Institute of Telecommunication

Release Notes: - Updated resistor values for Voltage Measurement Interface Printing Notes: Print as ANSI D size on HP Designjet

With Inked Are optimization and
No Auto rotate From 36" width roll

University of California, Irvine v.1.4Fv4 (c) 2018

TITLE: Isolated 3-Phase AC Power Meter - SPI Interface

Team Members:
P. Nguyen, J. Wan, J. Baez, E. Granizo, & D. Brady
Project Advisors:
Michael Klopfer, PhD. & Prof. G.P. Li

6/13/2019 4:36 PM C:\Users\Esteban\Documents\GitHub\ADE9078-3PhaseWattmeter\PCBDesign\1.4Fv4\1.4Fv4.sch (Sheet: 1/1)
