CalPlug/ADE9078-3PhaseWattmeter/PCBDesign/1.4Fv4/1.4Fv4.pdf

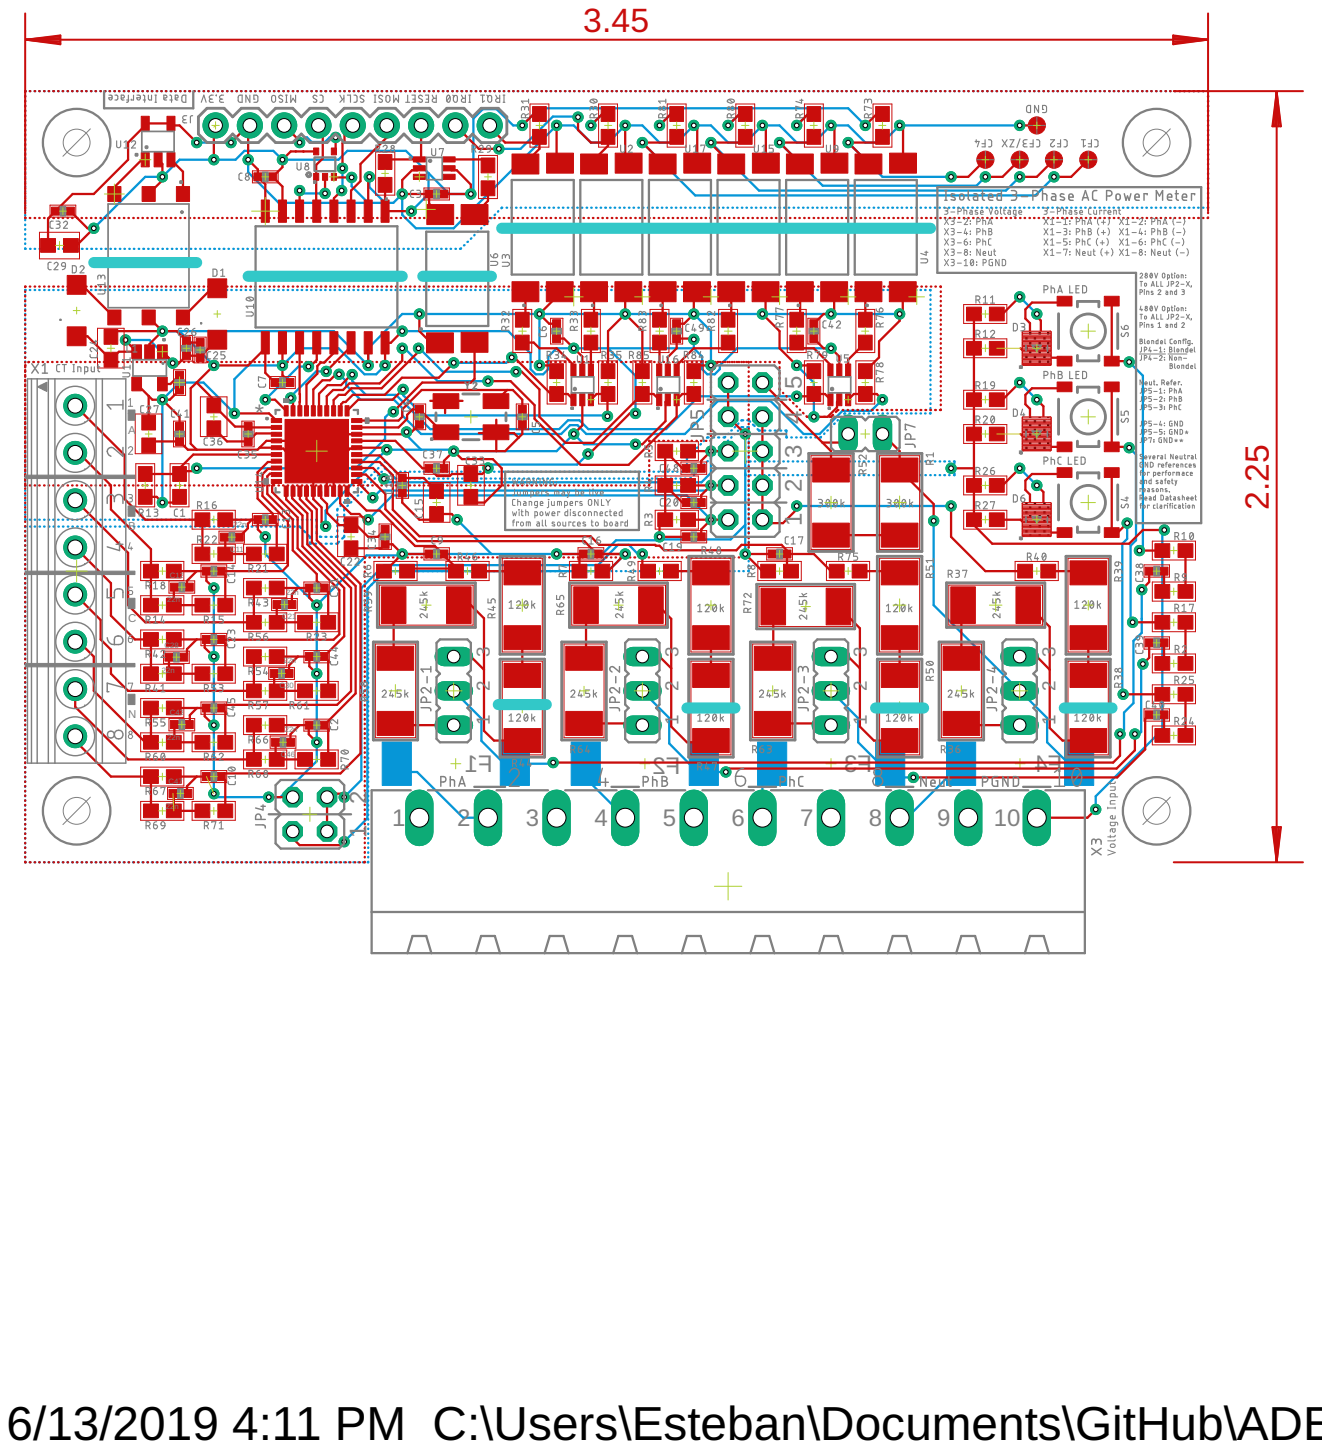
[picture p34: page 1]

6/13/2019 4:11 PM C:\Users\Esteban\Documents\GitHub\ADE9078-3PhaseWattmeter\PCBDesign\1.4Fv4\1.4Fv4.brd
