CalPlug/ADE9078-3PhaseWattmeter/PCBDesign/prior versions/ADC Optimized/Polyphase1.0F (2).pdf

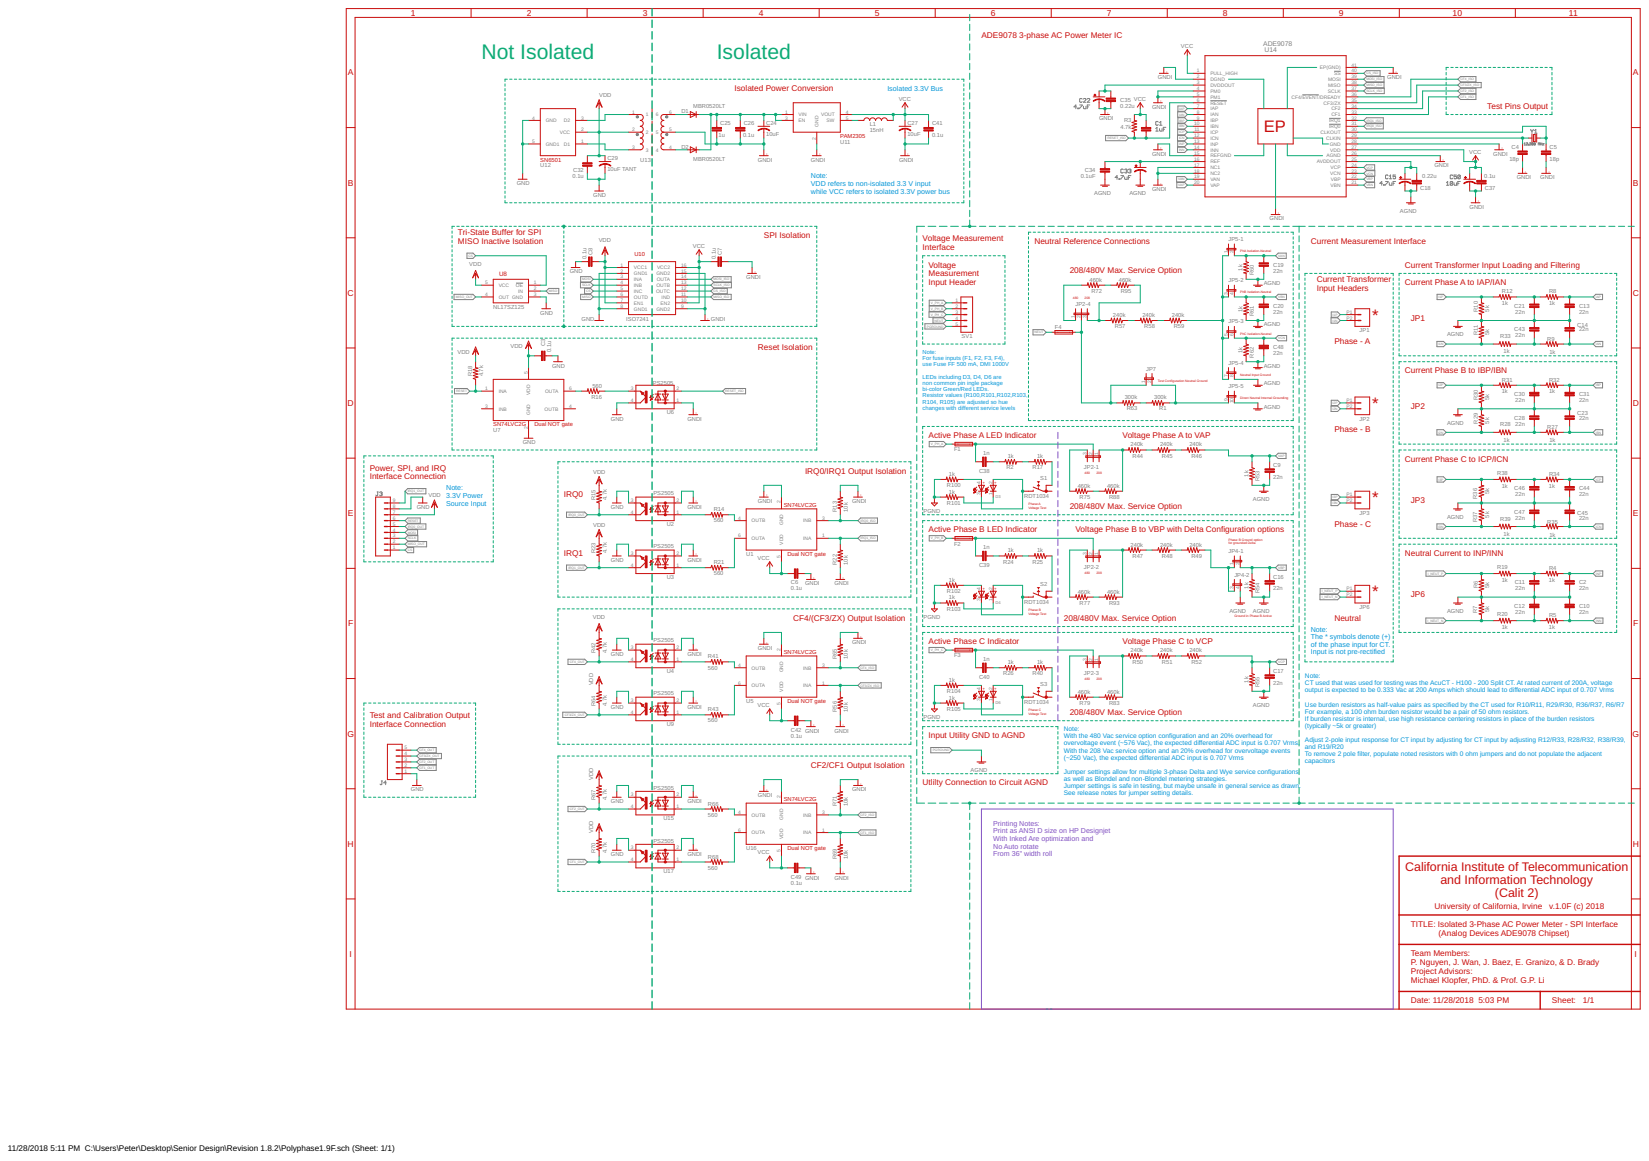
[picture p35: page 1]

ADE9078 3-phase AC Power Meter IC

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

Tri-State Buffer for SPI

Current Transformer Input Loading and Filtering

Current Phase A to IAP/IAN

Note: For fuse inputs (F1, F2, F3, F4), use Fuse FF 500 mA, DMI 1000V

Current Phase B to IBP/IBN

LEDs including D3, D4, D6 are
non common pin ingle package
bi-color Green/Red LEDs. Resistor values (R100,R101,R102,R103, R104, R105) are adjusted so hue

Neutral Input Ground Direct Neutral Internal Grounding

Test Configuration Neutral Ground

changes with different service levels

Active Phase A LED Indicator

Voltage Phase A to VAP

Current Phase C to ICP/ICN

Power, SPI, and IRQ
Interface Connection

Active Phase B LED Indicator

Voltage Phase B to VBP with Delta Configuration options

Neutral Current to INP/INN

GNDI 1

Ground in Phase B Active

The * symbols denote (+)
of the phase input for CT.
Input is not pre-rectified

Voltage Phase C to VCP

Note: CT used that was used for testing was the AcuCT - H100 - 200 Split CT. At rated current of 200A, voltage

output is expected to be 0.333 Vac at 200 Amps which should lead to differential ADC input of 0.707 Vrms Use burden resistors as half-value pairs as specified by the CT used for R10/R11, R29/R30, R36/R37, R6/R7

Dual NOT gate CF2/CF1 Output Isolation

For example, a 100 ohm burden resistor would be a pair of 50 ohm resistors.
If burden resistor is internal, use high resistance centering resistors in place of the burden resistors
(typically ~5k or greater)

Test and Calibration Output

To remove 2 pole filter, populate noted resistors with 0 ohm jumpers and do not populate the adjacent capacitors Note: With the 480 Vac service option configuration and an 20% overhead for overvoltage event (~576 Vac), the expected differential ADC input is 0.707 Vrms. With the 208 Vac service option and an 20% overhead for overvoltage events

Input Utility GND to AGND

Adjust 2-pole input response for CT input by adjusting for CT input by adjusting R12/R33, R28/R32, R38/R39, and R19/R20

(~250 Vac), the expected differential ADC input is 0.707 Vrms

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

Utlilty Connection to Circuit AGND

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

California Institute of Telecommunication and Information Technology (Calit 2) University of California, Irvine v.1.0F (c) 2018

TITLE: Isolated 3-Phase AC Power Meter - SPI Interface (Analog Devices ADE9078 Chipset)

Team Members: P. Nguyen, J. Wan, J. Baez, E. Granizo, & D. Brady Project Advisors: Michael Klopfer, PhD. & Prof. G.P. Li | I

Date: 11/28/2018 5:03 PM | Sheet: 1/1

11/28/2018 5:11 PM C:\Users\Peter\Desktop\Senior Design\Revision 1.8.2\Polyphase1.9F.sch (Sheet: 1/1)
