CalPlug/ADE9078-3PhaseWattmeter/PCBDesign/1.4Fv3(PCB Populated)/Board PDF images/Bottom Traces.pdf

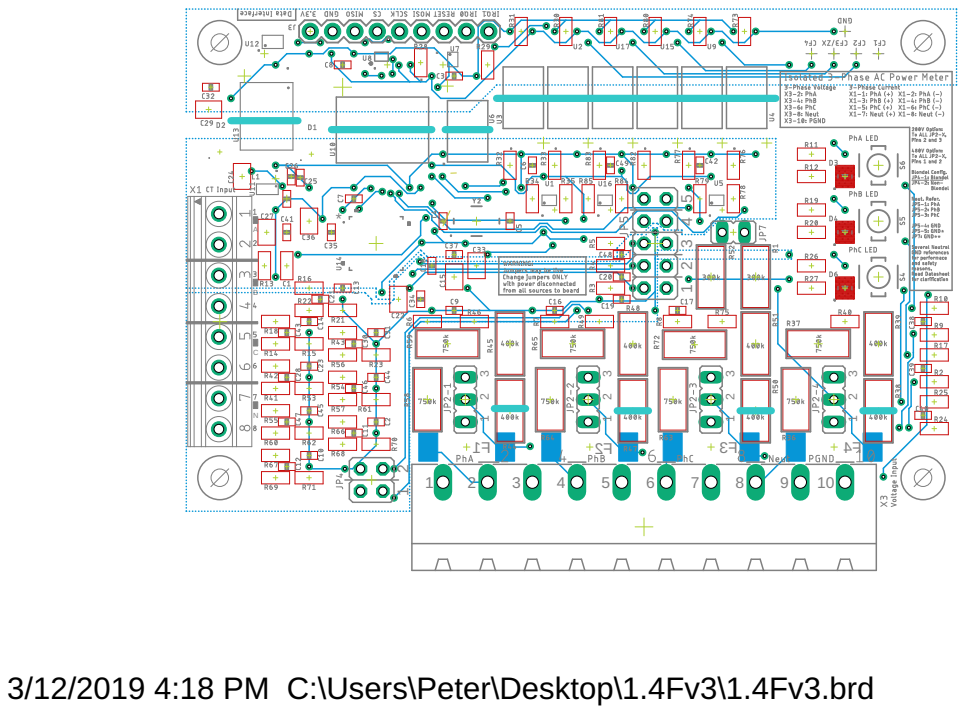
[picture p37: page 1]

3/12/2019 4:18 PM C:\Users\Peter\Desktop\1.4Fv3\1.4Fv3.brd
