CalPlug/ADE9078-3PhaseWattmeter/PCBDesign/1.4Fv3(PCB Populated)/Board PDF images/Top Traces with Ground Plane.pdf

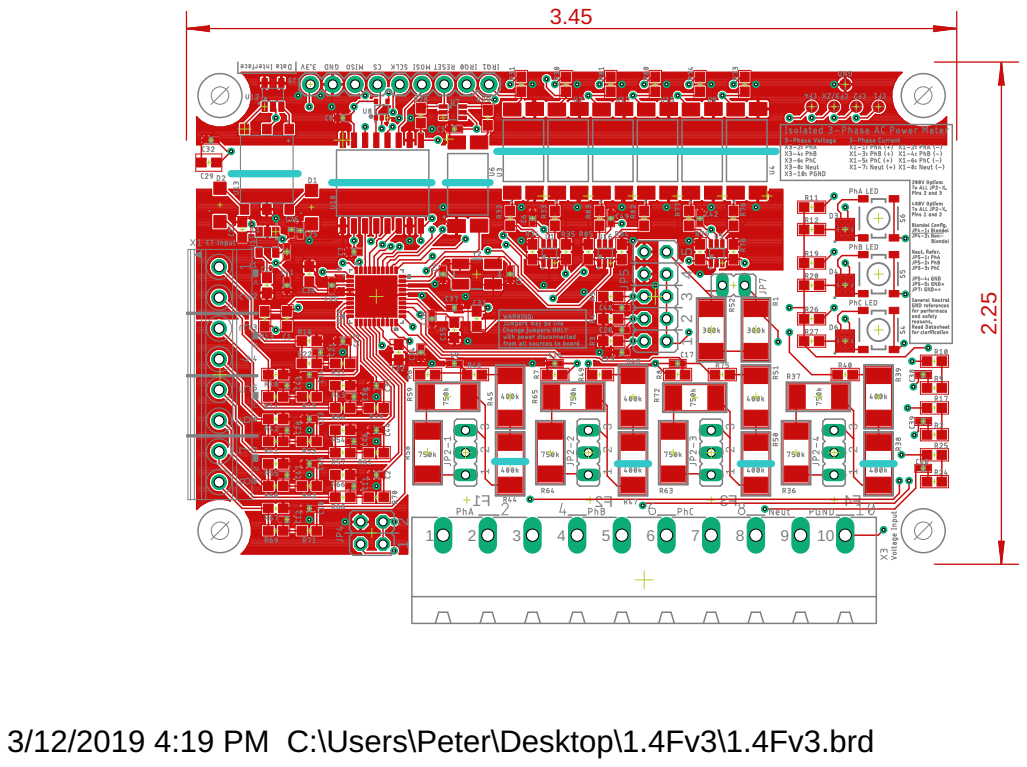
[picture p38: page 1]

3/12/2019 4:19 PM C:\Users\Peter\Desktop\1.4Fv3\1.4Fv3.brd
