CalPlug/ADE9078-3PhaseWattmeter/PCBDesign/simulations/LTSpice/Sim1-CTSimulationCurrentInput/3phasemeter_current.asc

C1: cap; 22n
C2: cap; 22n
C3: cap; 22n
C4: cap; 22n
L1: ind2; 1µ
L2: ind2; 1000000µ; Rser=50
R1: res; 51
R2: res; 1k
R3: res; 51
R4: res; 1k
R5: res; 10000
R6: res; {R}
R7: res; 10000
V1: voltage; SINE(0 220 60); AC 1; Rser=.1
Named nets: 0, Vin+, Vin-
Help:  http://denethor.wlu.ca/ltspice/
SPICE Simulation Directives
Analog Ground / Power Ground
ADC Input +
ADC Input -
Current Transformer Input
.step param R list 10 50 100 1000 5000
K1 L1 L2 0.99
--------------------------------
--------------------------------
----------------------------
----------------------------
1:1000 Turns Ratio CT
Resistive Load
.op
.tran 0 .1 0 .001
