CalPlug/ADE9078-3PhaseWattmeter/PCBDesign/simulations/LTSpice/Sim2 - VoltageChInputToADC/3phasemeter.asc

C1: cap; 22n
C2: cap; 22n
C3: cap; 22n
D1: diode; 1N914
D2: diode; 1N914
R1: res; 2k
R2: res; 1K
R3: res; 300k
R4: res; 900k
R5: res; 300K
R6: res; 1k
R7: res; 300k
R8: res; 300K
R9: res; 900k
V1: voltage; ""; AC 480; Rser=0.5
Named nets: 0, Vin+, Vin-
Help:  http://denethor.wlu.ca/ltspice/
SPICE Simulation Directives
;dc V1 -240 240 0.5
LED Indicator
Analog Ground / Power Ground
ADC Input +
480V Service Option (jump to remove)
ADC Input -
480V Service Option (jump to remove)
Single Phase Input
.ac lin 1000 1 100000
