CalPlug/ADE9078-3PhaseWattmeter/PCBDesign/1.4Fv4/1.4Fv4.brd

## EAGLE design PCBDesign/1.4Fv4/1.4Fv4.brd (2019-04-18)

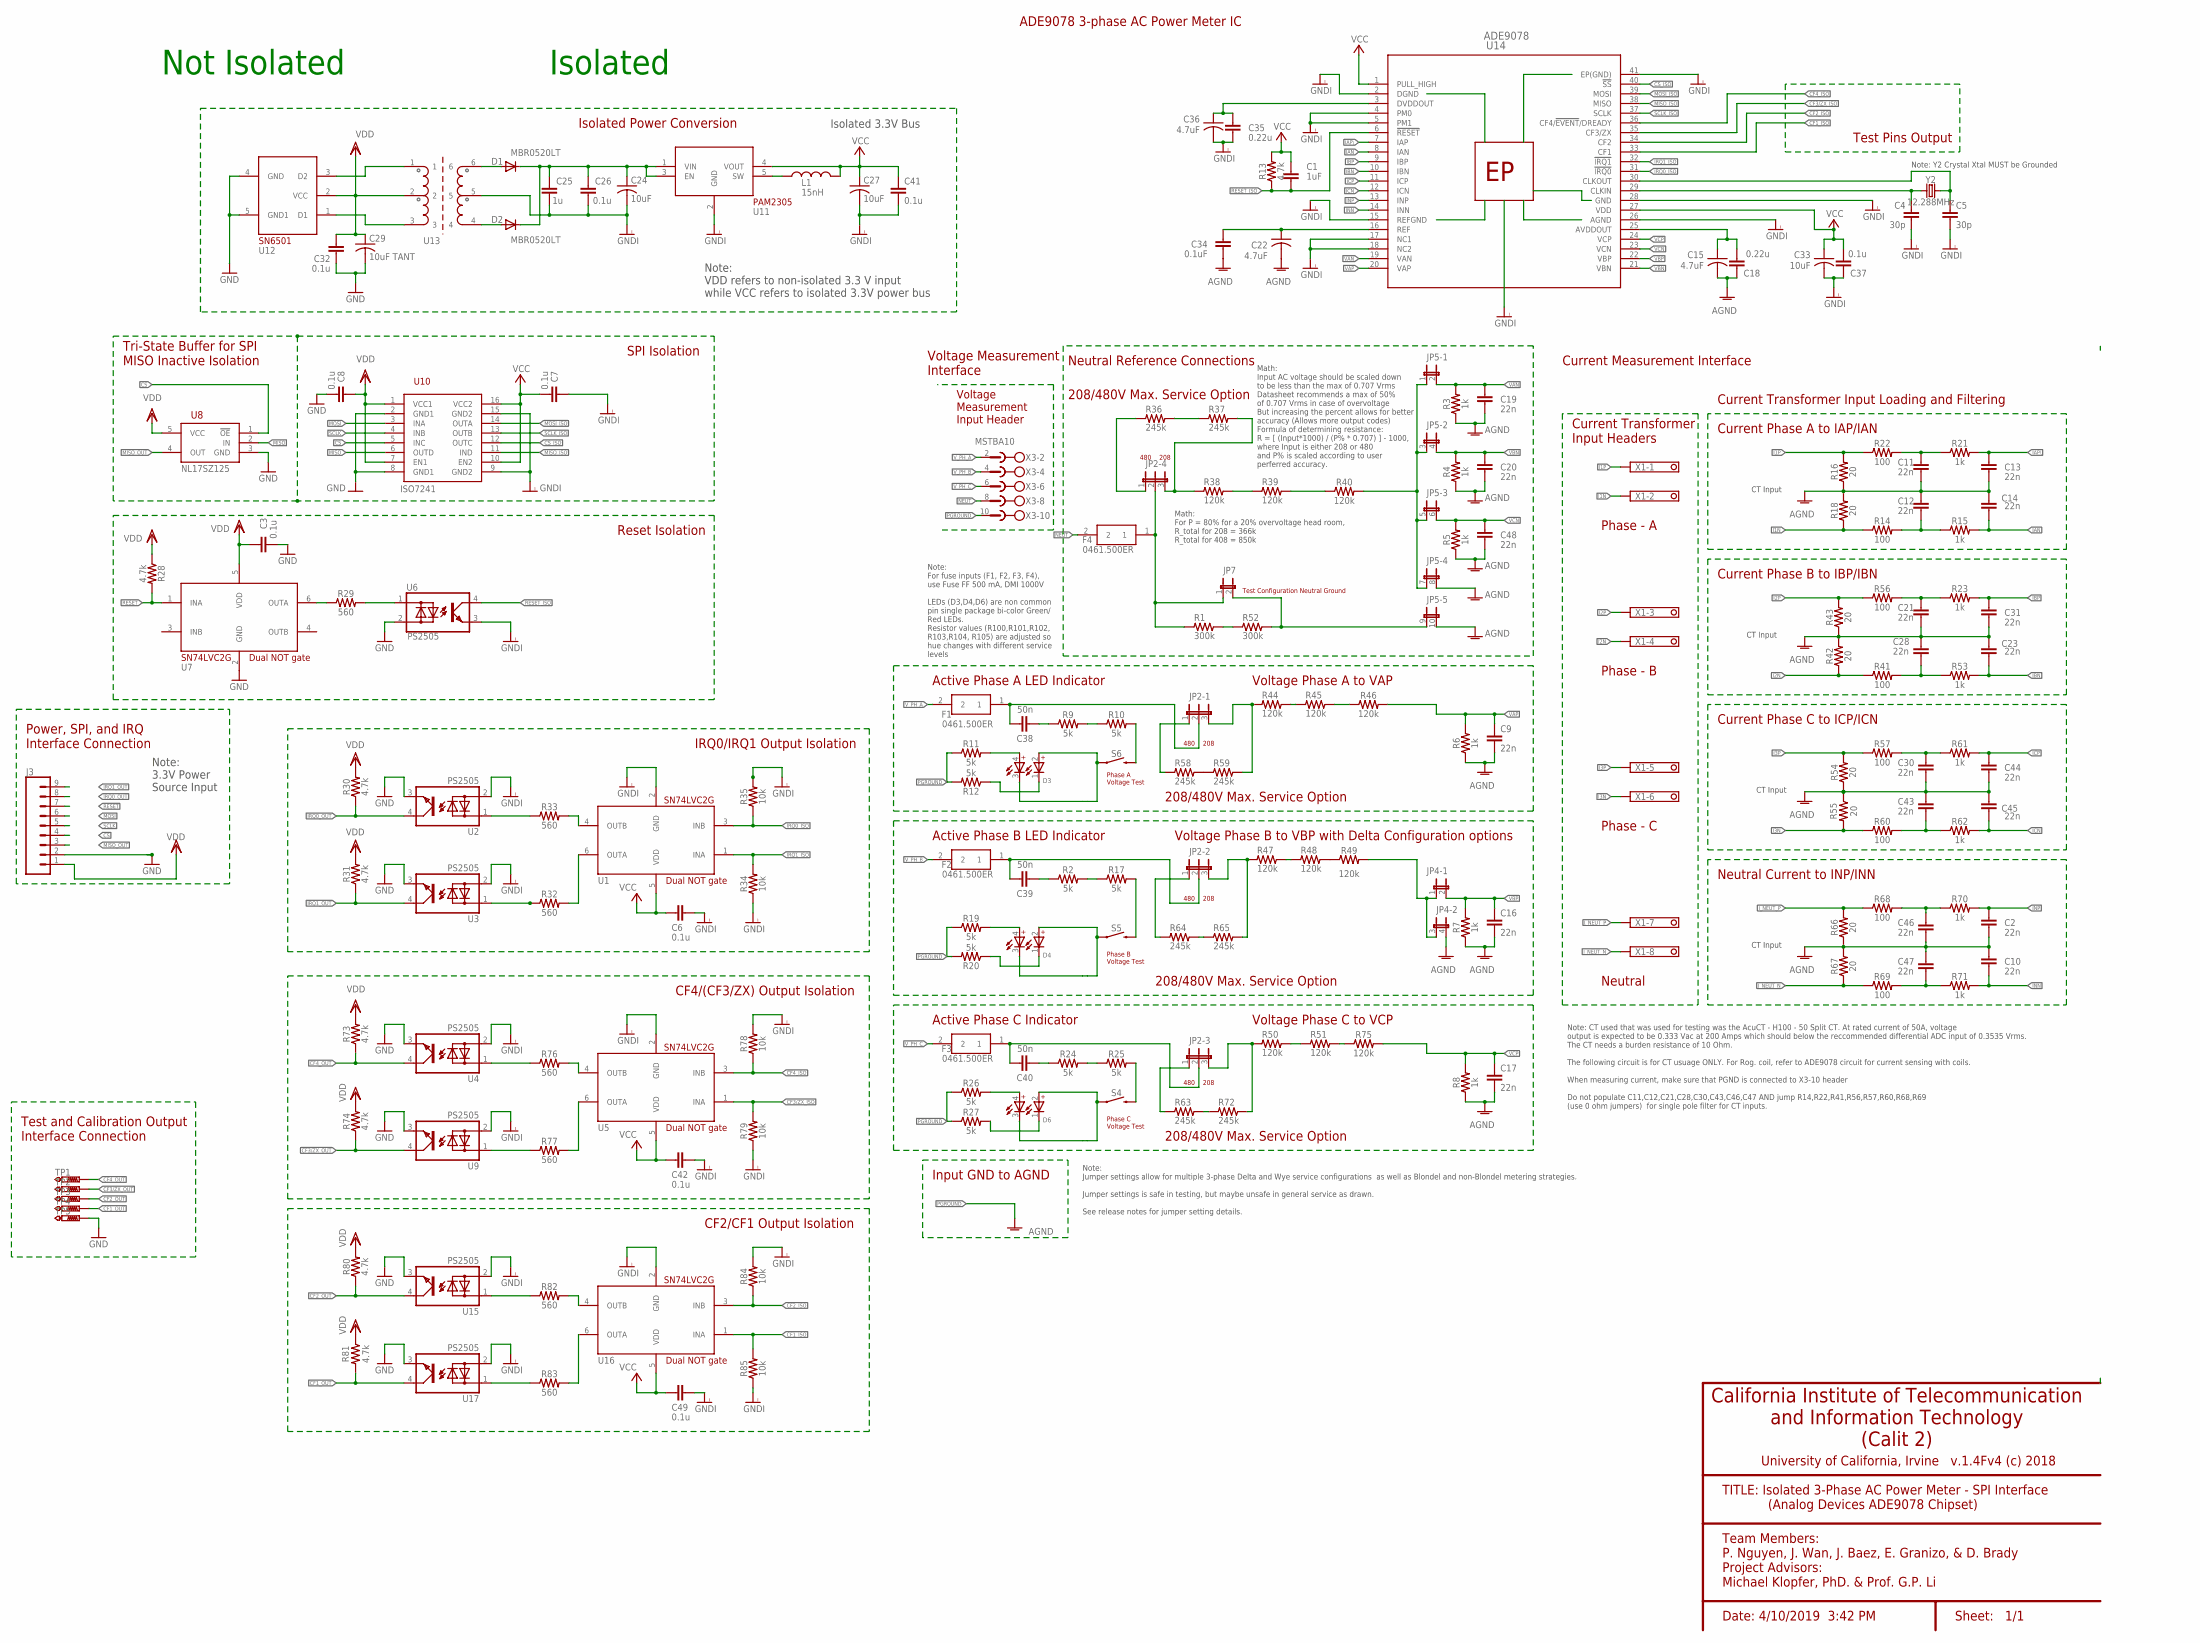
[picture p40: schematic 1.4Fv4.sch]

Parts:
C1: 1uF; 0603; MPN MC0805B104K500A5.08MM
C2, C9, C10, C11, C12, C13, C14, C16, C17, C19, C20, C21, C23, C28, C30, C31, C43, C44, C45, C46, C47, C48: 22n; 0402-CAP; MPN C0603C223K5RACTU
C3, C6, C7, C8, C26, C32, C37, C41, C42, C49: 0.1u; 0402-CAP; MPN C0603X5R1A104K030BC
C4, C5: 30p; 0402-CAP; MPN MC0402N180J500CT
C15, C22, C36: 4.7uF; C0603; MPN C1608X5R1A106K080AC
C18, C35: 0.22u; 0402-CAP; MPN MC0805F224Z500CT
C24, C27, C33: 10uF; C0603; MPN C1608X5R1A106K080AC
C25: 1u; 0402-CAP; MPN C0603X5R1A104K030BC
C29: 10uF TANT; C0603; MPN 195D106X96R3V2T
C34: 0.1uF; 0402-CAP; MPN C0603X5R1A104K030BC
C38, C39, C40: 50n; 0402-CAP; MPN C0603C223K5RACTU
D1, D2: MBR0520LT; SOD123; MPN MBR0520LT1G.
D3, D4, D6: WL-SBCW_0606_150066SV74000; WL-SBCW_0606
F1, F2, F3, F4: 0461.500ER; FUSC10131X312N
J3: CONN_09; 1X09; MPN 350547-1
JP2-1, JP2-2, JP2-3, JP2-4: JP2E; JP2
JP4: JP2QE; JP2Q; MPN 350547-1
JP5: JP5QE; JP5Q; MPN 350547-1
JP7: JP1E; JP1
L1: 15nH; 0402-RES
R1, R52: 300k; R2010
R2, R9, R10, R11, R12, R17, R19, R20, R24, R25, R26, R27: 5k; 0603
R3, R4, R5, R6, R7, R8, R15, R21, R23, R53, R61, R62, R70, R71: 1k; 0603
R13, R28, R30, R31, R73, R74, R80, R81: 4.7k; 0603
R14, R22, R41, R56, R57, R60, R68, R69: 100; 0603
R16, R18, R42, R43, R54, R55, R66, R67: 20; 0603
R29, R32, R33, R76, R77, R82, R83: 560; 0603
R34, R35, R78, R79, R84, R85: 10k; 0603
R36, R37, R58, R59, R63, R64, R65, R72: 245k; R2010
R38, R39, R44, R45, R47, R48, R50, R51: 120k; R2010
R40, R46, R49, R75: 120k; 0603
S4, S5, S6: MOMENTARY-SWITCH-SPST-SMD-4.5MM; TACTILE_SWITCH_SMD_4.5MM
TP1, TP2, TP3, TP4, TP5: PTR1B1,27; B1,27
U1, U5, U7, U16: SN74LVC; DCKT; MPN SN74LVC1G34DBVR
U2, U3, U4, U6, U9, U15, U17: PS2505; MPN PS2505-4-A
U8: NL17SZ125; MPN SN74LVC1G125DRLR
U10: ISO7241; 16-SOIC; MPN ISO7241CQDWRQ1
U11: PAM2305; TSOT25
U12: SN6501; SOT-23-5; MPN SN6501DBVT
U13: TRANSFO_3.3
U14: ADE9078; CP_40_7; MPN ADE9078ACPZ
X1: 1751303
X3: MSTBA10
Y2: 12.288MHz; CRYSTAL-SMD-5X3.2-4PAD

Connections:
AGND: C2.1, C9.2, C10.2, C11.1, C12.2, C13.1, C14.2, C15.2, C16.2, C17.2, C18.1, C19.2, C20.2, C21.1, C22.2, C23.2, C28.2, C30.1, C31.1, C34.1, C43.2, C44.1, C45.2, C46.1, C47.2, C48.2, JP4.4 (2), JP5.8 (2), JP5.10 (2), R3.1, R4.1, R5.1, R6.1, R7.1, R8.1, R16.1, R18.2, R42.2, R43.1, R54.1, R55.1, R66.1, R67.2
AVDDOUT: C15.1, C18.2, U14.25 (AVDDOUT)
CF1_ISO: R85.2, U14.33 (CF1), U16.1 (INA)
CF1_OUT: R81.2, TP4.TP, U17.4 (COLLERTOR)
CF2_ISO: R84.1, U14.34 (CF2), U16.3 (INB)
CF2_OUT: R80.1, TP3.TP, U15.4 (COLLERTOR)
CF3/ZX_ISO: R79.2, U5.1 (INA), U14.35 (CF3/ZX)
CF3/ZX_OUT: R74.1, TP2.TP, U9.4 (COLLERTOR)
CF4_ISO: R78.1, U5.3 (INB), U14.36 (CF4/!EVENT!/DREADY)
CF4_OUT: R73.1, TP1.TP, U4.4 (COLLERTOR)
CS: J3.4, U8.1 (!OE), U10.5 (INC)
CS_ISO: U10.12 (OUTC), U14.40 (!SS)
DVDDOUT: C35.2, C36.1, U14.3 (DVDDOUT)
GND: C3.2, C8.2, C29.2, C32.1, J3.2, TP5.TP, U2.3 (EMITTER), U3.3 (EMITTER), U4.3 (EMITTER), U6.2 (CATHODE), U7.2 (GND), U8.3 (GND), U9.3 (EMITTER), U10.2 (GND1), U10.8 (GND1), U12.4 (GND), U12.5 (GND1), U15.3 (EMITTER), U17.3 (EMITTER)
GNDI: C4.1, C5.2, C6.1, C7.1, C24.2, C25.1, C26.1, C27.2, C33.2, C35.1, C36.2, C37.1, C41.2, C42.1, C49.1, R34.1, R35.2, R78.2, R79.1, R84.2, R85.1, U1.2 (GND), U2.2 (CATHODE), U3.2 (CATHODE), U4.2 (CATHODE), U5.2 (GND), U6.3 (EMITTER), U9.2 (CATHODE), U10.9 (GND2), U10.15 (GND2), U11.2 (GND), U13.5, U14.2 (DGND), U14.4 (PM0), U14.5 (PM1), U14.15 (REFGND), U14.17 (NC1), U14.18 (NC2), U14.26 (AGND), U14.28 (GND), U14.41 (EP(GND)), U15.2 (CATHODE), U16.2 (GND), U17.2 (CATHODE)
I1N: R14.1, R18.1, X1.2
I1P: R16.2, R22.1, X1.1
I2N: R41.1, R42.1, X1.4
I2P: R43.2, R56.1, X1.3
I3N: R55.2, R60.1, X1.6
I3P: R54.2, R57.1, X1.5
IAN: C14.1, R15.2, U14.8 (IAN)
IAP\: C13.2, R21.2, U14.7 (IAP)
IBN: C23.1, R53.2, U14.10 (IBN)
IBP: C31.2, R23.2, U14.9 (IBP)
ICN: C45.1, R62.2, U14.12 (ICN)
ICP: C44.2, R61.2, U14.11 (ICP)
INN: C10.1, R71.2, U14.14 (INN)
INP: C2.2, R70.2, U14.13 (INP)
IRQ0_ISO: R35.1, U1.3 (INB), U14.31 (!IRQ0)
IRQ0_OUT: J3.8, R30.1, U2.4 (COLLERTOR)
IRQ1_ISO: R34.2, U1.1 (INA), U14.32 (!IRQ1)
IRQ1_OUT: J3.9, R31.1, U3.4 (COLLERTOR)
I_NEUT_N: R67.1, R69.1, X1.8
I_NEUT_P: R66.2, R68.1, X1.7
MISO: U8.2 (IN), U10.6 (OUTD)
MISO_ISO: U10.11 (IND), U14.38 (MISO)
MISO_OUT: J3.3, U8.4 (OUT)
MOSI: J3.6, U10.3 (INA)
MOSI_ISO: U10.14 (OUTA), U14.39 (MOSI)
unnamed: C5.1, U14.30 (CLKOUT), Y2.3 (2)
unnamed: C11.2, R21.1, R22.2
unnamed: C12.1, R14.2, R15.1
unnamed: L1.1, U11.5 (SW)
unnamed: C30.2, R57.2, R61.1
unnamed: C43.1, R60.2, R62.1
unnamed: C38.2, R9.1
unnamed: R32.2, U1.6 (OUTA)
unnamed: R32.1, U3.1 (ANODE)
unnamed: C4.2, U14.29 (CLKIN), Y2.1
unnamed: R25.2, S4.1 (2), S4.4 (2)
unnamed: D1.A, U13.6
unnamed: C24.1, C25.2, C26.2, D1.C, D2.C, U11.1 (VIN), U11.3 (EN)
unnamed: D2.A, U13.4
unnamed: U12.3 (D2), U13.1
unnamed: U12.1 (D1), U13.3
unnamed: C21.2, R23.1, R56.2
unnamed: R29.2, U6.1 (ANODE)
unnamed: R29.1, U7.6 (OUTA)
unnamed: C28.1, R41.2, R53.1
unnamed: R9.2, R10.1
unnamed: R33.2, U1.4 (OUTB)
unnamed: R76.2, U5.4 (OUTB)
unnamed: R1.2, R52.1
unnamed: R64.2, R65.1
unnamed: R33.1, U2.1 (ANODE)
unnamed: JP2-1.1, R58.1
unnamed: R58.2, R59.1
unnamed: R10.2, S6.1 (2), S6.4 (2)
unnamed: JP2-1.3, R44.1, R59.2
unnamed: JP2-2.1, R64.1
unnamed: JP2-2.3, R47.1, R65.2
unnamed: R63.2, R72.1
unnamed: C46.2, R68.2, R70.1
unnamed: JP2-4.3, R37.2, R38.1
unnamed: JP2-4.1, R36.1
unnamed: R36.2, R37.1
unnamed: JP5.9 (1), JP7.2, R52.2
unnamed: C47.1, R69.2, R71.1
unnamed: C39.2, R2.1
unnamed: R2.2, R17.1
unnamed: R17.2, S5.1 (2), S5.4 (2)
unnamed: D3.1 (C2), R12.1
unnamed: D6.2 (A2), D6.3 (C1), S4.2 (1), S4.3 (1)
unnamed: C40.2, R24.1
unnamed: R24.2, R25.1
unnamed: D3.4 (A1), R11.2
unnamed: D4.2 (A2), D4.3 (C1), S5.2 (1), S5.3 (1)
unnamed: R76.1, U4.1 (ANODE)
unnamed: R77.1, U9.1 (ANODE)
unnamed: R77.2, U5.6 (OUTA)
unnamed: JP5.1, JP5.3 (1), JP5.5 (1), JP5.7 (1), R40.2
unnamed: R82.1, U15.1 (ANODE)
unnamed: R83.1, U17.1 (ANODE)
unnamed: R83.2, U16.6 (OUTA)
unnamed: D3.2 (A2), D3.3 (C1), S6.2 (1), S6.3 (1)
unnamed: D4.4 (A1), R19.2
unnamed: R45.2, R46.1
unnamed: C40.1, F3.1, JP2-3.2
unnamed: F4.1, JP2-4.2, JP7.1, R1.1
unnamed: C38.1, F1.1, JP2-1.2
unnamed: R48.2, R49.1
unnamed: JP2-3.3, R50.1, R72.2
unnamed: JP4.1, JP4.3 (1), R49.2
unnamed: C39.1, F2.1, JP2-2.2
unnamed: JP2-3.1, R63.1
unnamed: R50.2, R51.1
unnamed: R51.2, R75.1
unnamed: R82.2, U16.4 (OUTB)
unnamed: R44.2, R45.1
unnamed: R47.2, R48.1
unnamed: R38.2, R39.1
unnamed: R39.2, R40.1
unnamed: D4.1 (C2), R20.1
unnamed: D6.1 (C2), R27.2
unnamed: D6.4 (A1), R26.2
NEUT: F4.2, X3.8
PGROUND: R11.1, R12.2, R19.1, R20.2, R26.1, R27.1, X3.10
REF: C22.1, C34.2, U14.16 (REF)
RESET: J3.7, R28.2, U7.1 (INA)
RESET_ISO: C1.2, R13.1, U6.4 (COLLERTOR), U14.6 (!RESET)
SCLK: J3.5, U10.4 (INB)
SCLK_ISO: U10.13 (OUTB), U14.37 (SCLK)
VAN: C19.1, JP5.2, R3.2, U14.19 (VAN)
VAP: C9.1, R6.2, R46.2, U14.20 (VAP)
VBN: C20.1, JP5.4 (2), R4.2, U14.21 (VBN)
VBP: C16.1, JP4.2, R7.2, U14.22 (VBP)
VCC: C1.1, C6.2, C7.2, C27.1, C33.1, C37.2, C41.1, C42.2, C49.2, L1.2, R13.2, U1.5 (VDD), U5.5 (VDD), U10.10 (EN2), U10.16 (VCC2), U11.4 (VOUT), U14.1 (PULL_HIGH), U14.27 (VDD), U16.5 (VDD)
VCN: C48.1, JP5.6 (2), R5.2, U14.23 (VCN)
VCP: C17.1, R8.2, R75.2, U14.24 (VCP)
VDD: C3.1, C8.1, C29.1, C32.2, J3.1, R28.1, R30.2, R31.2, R73.2, R74.2, R80.2, R81.1, U7.5 (VDD), U8.5 (VCC), U10.1 (VCC1), U10.7 (EN1), U12.2 (VCC), U13.2
V_PH_A: F1.2, X3.2
V_PH_B: F2.2, X3.4
V_PH_C: F3.2, X3.6

Notes on the sheet:
Not Isolated
Isolated
Isolated Power Conversion
Note: VDD refers to non-isolated 3.3 V input while VCC refers to isolated 3.3V power bus
Isolated 3.3V Bus
ISO7241
SPI Isolation
Tri-State Buffer for SPI MISO Inactive Isolation
Dual NOT gate
Reset Isolation
Power, SPI, and IRQ Interface Connection
Note: 3.3V Power Source Input
IRQ0/IRQ1 Output Isolation
CF4/(CF3/ZX) Output Isolation
Test and Calibration Output Interface Connection
CF2/CF1 Output Isolation
ADE9078 3-phase AC Power Meter IC
Current Measurement Interface
Test Pins Output
Voltage Measurement Interface
Voltage Measurement Input Header
Voltage Phase A to VAP
Voltage Phase B to VBP with Delta Configuration options
Voltage Phase C to VCP
Input GND to AGND
Neutral Reference Connections
Current Transformer Input Headers
Current Phase A to IAP/IAN
Current Phase B to IBP/IBN
Current Phase C to ICP/ICN
Neutral Current to INP/INN
Active Phase A LED Indicator
Active Phase B LED Indicator
Active Phase C Indicator
Current Transformer Input Loading and Filtering
Phase - A
Phase - B
Phase - C
Neutral
Date: 4/10/2019 3:42 PM
Team Members: P. Nguyen, J. Wan, J. Baez, E. Granizo, & D. Brady Project Advisors: Michael Klopfer, PhD. & Prof. G.P. Li
Sheet: 1/1
TITLE: Isolated 3-Phase AC Power Meter - SPI Interface (Analog Devices ADE9078 Chipset)
California Institute of Telecommunication and Information Technology (Calit 2)
University of California, Irvine v.1.4Fv4 (c) 2018
208/480V Max. Service Option
Note: For fuse inputs (F1, F2, F3, F4), use Fuse FF 500 mA, DMI 1000V LEDs (D3,D4,D6) are non common pin single package bi-color Green/ Red LEDs. Resistor values (R100,R101,R102, R103,R104, R105) are adjusted so hue changes with different service levels
Note: Jumper settings allow for multiple 3-phase Delta and Wye service configurations as well as Blondel and non-Blondel metering strategies. Jumper settings is safe in testing, but maybe unsafe in general service as drawn. See release notes for jumper setting details.
Note: CT used that was used for testing was the AcuCT - H100 - 50 Split CT. At rated current of 50A, voltage output is expected to be 0.333 Vac at 200 Amps which should below the reccommended differential ADC input of 0.3535 Vrms. The CT needs a burden resistance of 10 Ohm. The following circuit is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
480
208
Test Configuration Neutral Ground
Phase A Voltage Test
Phase B Voltage Test
Phase C Voltage Test
Note: Y2 Crystal Xtal MUST be Grounded
Math: Input AC voltage should be scaled down to be less than the max of 0.707 Vrms Datasheet recommends a max of 50% of 0.707 Vrms in case of overvoltage But increasing the percent allows for better accuracy (Allows more output codes) Formula of determining resistance: R = [ (Input*1000) / (P% * 0.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
Math: For P = 80% for a 20% overvoltage head room, R_total for 208 = 366k R_total for 408 = 850k
CT Input

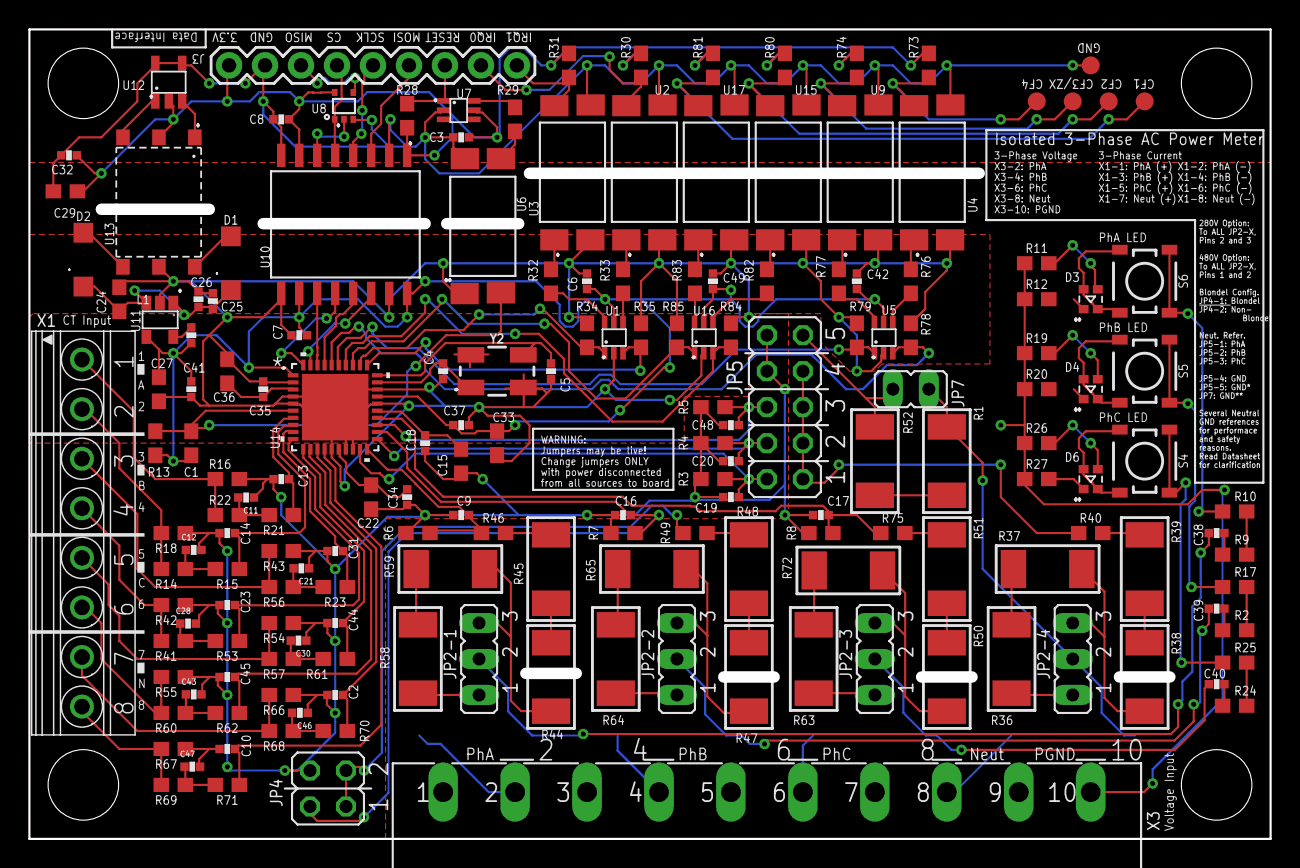
[picture p41: board 1.4Fv4.brd from above]

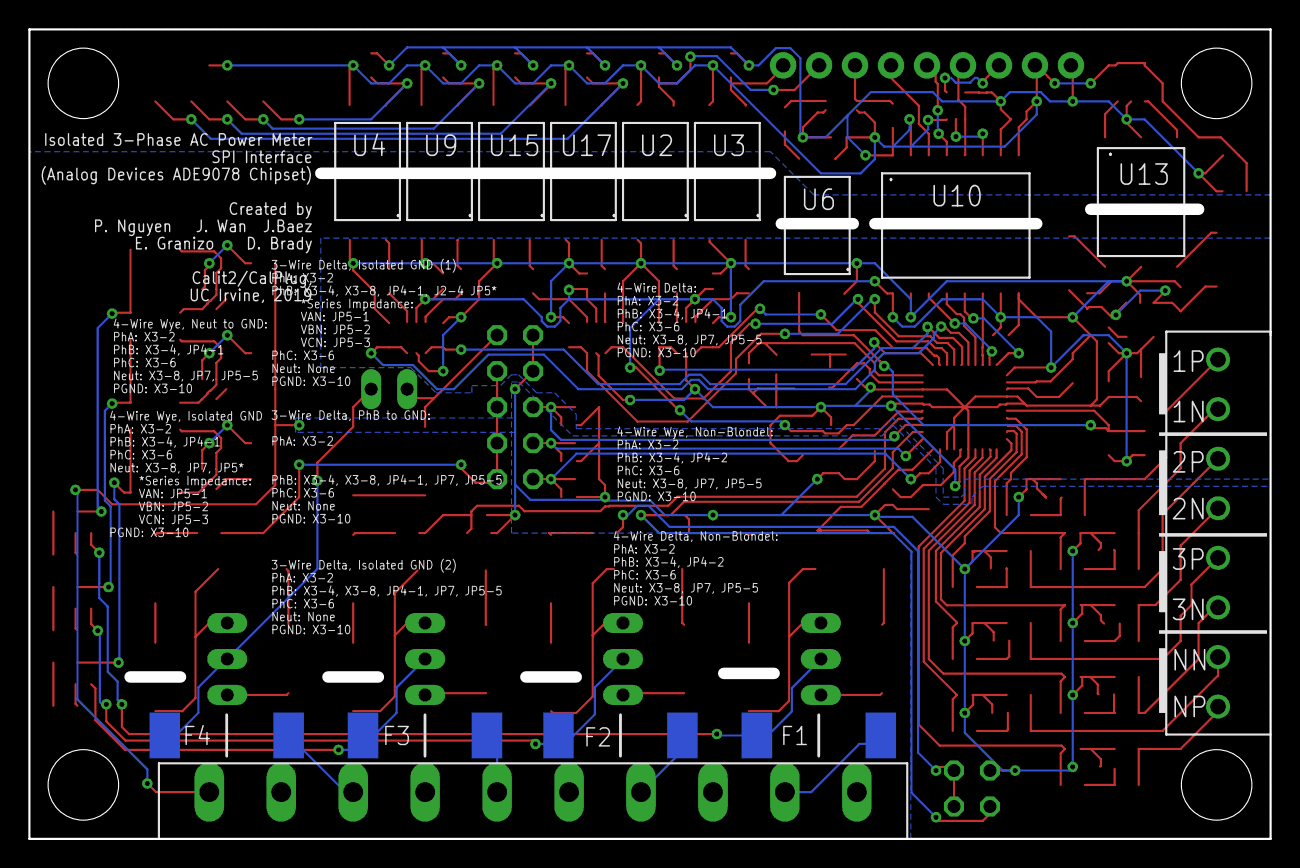
[picture p42: board 1.4Fv4.brd from below]

Board: 2 copper layers, 87.6 x 57.1 mm, 180 parts (4 on the bottom side), 134 nets.
