CalPlug/ADE9078-3PhaseWattmeter/Firmware/ArduinoFirmware/ADE9078/ADE9078Calibrations.h

#define AVrmsGain 	0.000014186
#define AVrmsOffset 11.67676
#define BVrmsGain 	0.000015946
#define BVrmsOffset 9.09546
#define CVrmsGain 	0.000014650
#define CVrmsOffset 4.88559

#define AIrmsGain 	0.00000541212
#define AIrmsOffset 6.0764
#define BIrmsGain 	0.00000541212
#define BIrmsOffset 6.0764
#define CIrmsGain 	0.00000541212
#define CIrmsOffset 6.0764

#define AWattHrGain 1
#define AWattHrOffset 0
#define BWattHrGain 1
#define BWattHrOffset 0
#define CWattHrGain 1
#define CWattHrOffset 0

#define AAppPowerGain 1
#define AAppPowerOffset 0
#define BAppPowerGain 1
#define BAppPowerOffset 0
#define CAppPowerGain 1
#define CAppPowerOffset 0

#define AInstPowerGain 1
#define AInstPowerOffset 0
#define BInstPowerGain 1
#define BInstPowerOffset 0
#define CInstPowerGain 1
#define CInstPowerOffset 0

#define AInstReactivePowerGain 1
#define AInstReactivePowerOffset 0
#define BInstReactivePowerGain 1
#define BInstReactivePowerOffset 0
#define CInstReactivePowerGain 1
#define CInstReactivePowerOffset 0
