CalPlug/ADE9078-3PhaseWattmeter/(commit log)

2018-12-03 Initial Schematic
2018-12-03 Update ESP32 Lib
2018-12-06 Jwan -- fixed a typo
    [ADE9078.cpp]
2018-12-06 began removing duplicates and placing comments correctly. incomplete
    [ADE9078.cpp]
2018-12-06 fixed #defines to have name first, register second
    [ADE9078.cpp]
2018-12-06 cleaned comments. still needs reset/write
    [ADE9078.cpp]
2018-12-06 begain adding reset/access comments
    [ADE9078.cpp]
2018-12-07 added functions for a/b/c. getActiveEnergy, getReactiveEnergy, getApparentEnergy does not have funcs for all 3. needs comments for reset address and permissions on bits from end of datasheet
    [ADE9078.cpp, ADE9078.h]
2018-12-07 Jwan-added reset and access
    [ADE9078.cpp]
2018-12-07 added reset and access
    [ADE9078.cpp]
2019-01-25 changed read/writes to correctly begin/end transactions
    [ADE9078.cpp]
2019-02-08 handled compiler errors and warnings
    [ADE9078.cpp]
2019-02-14 Add Images of PCB
2019-02-23 made default settings in ade class to avoid retyping same thing. began rewriting debug lines
    [ADE9078.cpp]
2019-02-23 added debug lines to spi reads/writes and initialize
2019-02-27 renamed spi interface functions to be shorter. changed types to double and uint32_t
    [ADE9078.cpp]
2019-02-28 Update SPI transfer approach
2019-02-28 Update SPI settings for ESP32
2019-02-28 Update ESP32 Capability structure
2019-02-28 Update ESP32 SPI
2019-02-28 Tested on ESP32 and Arduino for compile
2019-02-28 Update SPI redefinition issue
    [ADE9078.cpp]
2019-02-28 Update SPI deff
2019-02-28 changed reads to correct command header
    [ADE9078.cpp, ADE9078.h]
2019-02-28 Update wiring mode selection
2019-02-28 Update Structure for wiring mode selection
2019-02-28 Update Calibration function
2019-02-28 added file for calibrations
2019-03-03 Update ESP32 compatability for CRC
2019-03-04 fixed indentation in .h. added most functions in 9000. typecasted before assigning
    [ADE9078.cpp, ADE9078.h]
2019-03-05 Update Template Calibration Firmware
2019-03-06 turns out staying awake cause you're thinking about koding helps you find bugs before you even test
    [resampledWFB.ino]
2019-03-06 peter's work: updated registers in calibration demo
2019-03-07 broken. assignment not working
    [resampledWFB.ino]
2019-03-08 maybe fixed seg fault bug. allocated space for fullResample
    [resampledWFB.ino]
2019-03-12 Most recent (March 2019) Design update
    [1.4Fv3.brd, 1.4Fv3.sch, BOM (NOA LABS TEMPLATE) March 2019.xlsx]
2019-03-13 calibration files edits
2019-03-13 calibrated voltage gain/offset. Unsure about current
2019-03-13 took out power variables
2019-03-15 added prints for debugging. fft demo not working. waveform sample demo running, but reading trash data. move variable declarations to functions to avoid crash on assign (sketch mem is read only)
    [ADE9078.cpp, ADE9078.h, resampledWFB.ino]
2019-03-15 changed demo.ino to just print A and B rms to serial
2019-03-16 Create ResampledFFTTemplate.ino
    Sample Layout for FFT based analysis
2019-03-17 revert back, see Crc_work_archive for moved code-J
    [ADEutility.h]
2019-03-22 Schematic update
    [1.4Fv3.sch]
2019-03-22 Updated for the schematic changes
    [BOM (NOA LABS TEMPLATE) March 2019.xlsx]
2019-04-05 Update Folder Structure for Archiving
    [LinearCalibrationCalculator.xls]
2019-04-10 Updated Schematic new version 1.4Fv4
    Updated notes on second pole filter
    [1.4Fv4.brd, 1.4Fv4.sch]
2019-04-10 Push up schematic with changes
    [1.4Fv4.brd, 1.4Fv4.sch]
2019-04-10 Changed resistor values 0->100
    [1.4Fv3.brd, 1.4Fv3.sch, 1.4Fv4.brd, 1.4Fv4.sch, BOM (NOA LABS TEMPLATE) March 2019.xlsx]
2019-04-10 Added pdf file of schematic
    [1.4Fv4.brd, 1.4Fv4.sch]
2019-04-10 Reorganized documents
    [1.4Fv3.brd, 1.4Fv3.sch, 1.4Fv4.brd, 1.4Fv4.sch, BOM (NOA LABS TEMPLATE) March 2019.xlsx]
2019-04-11 Adjusted notes
    [1.4Fv4.sch]
2019-04-12 Update Folder Structure
    [1.4Fv3.brd, 1.4Fv3.sch, BOM (NOA LABS TEMPLATE) March 2019.xlsx]
2019-04-12 Pushed the updated version of the BOM
    [BOM.xlsx]
2019-04-17 Update with David's comments
    [BOM (NOA LABS TEMPLATE) March 2019.xlsx]
2019-04-18 Updated BOM, changed schematic, and uploaded PDF of latest version under documents
    [1.4Fv4.brd, 1.4Fv4.sch, BOM (NOA LABS TEMPLATE) March 2019.xlsx, BOM - Three Phase Wattmeter.xlsx, BOM.xlsx]
2019-04-19 Update Locations
    [BOM - Three Phase Wattmeter.xlsx]
2019-04-23 Updated new BOM format
    [BOM - Three Phase Wattmeter.xlsx]
2019-04-23 PDF of PCB
2019-05-05 some wfb functions
    WFB: mode 0 mostly impleneted, working on mode 1
    still need to create interrupt functions to give data to user.
2019-05-14 updates to fft2
    i removed a bunch of print statements in the library
2019-06-03 fixed wfb
    had current and voltage reading in the wrong places
    [ADE9078.cpp, full_phase_graph.pde]
2019-06-04 blondel total current graphing option
2019-06-07 Helper program for calibration
2019-06-13 renamed file to fix issue
    [resampledWFB_FFT.ino]
2019-06-14 PDF of final PCB board design
    Uploaded final PCB board design (PDF)
2019-06-14 PDF of schematic
