CalPlug/ADE9078-3PhaseWattmeter/(notices)

Notices in the files:
PCBDesign/1.4Fv3(PCB Populated)/1.4Fv3.sch:
University of California, Irvine v.1.4Fv3 (c) 2018
parts and their libraries:
SparkFun-Connectors: Licensing: Creative Commons ShareAlike 4.0 International - https://creativecommons.org/licenses/by-sa/4.0
Wurth_Elektronik_Optoelectronics_rev18a: Copyright: Würth Elektronik
rc-master-smd: Copyright (C) 2007, Bob Starr
